fbezruchko/miro_production/README.md

# miro_production
All you need to make your own MIRO

In 3D print parts folders:
STL - STL files of part as-is.
STLwSUPPORTS - STL with modeled easy-detachable supports for FDM 3D printer with 0,2 mm layer hight.
