fbezruchko/miro_production/MIRO PARTS LIST & MANUFACTURING (RU).pdf

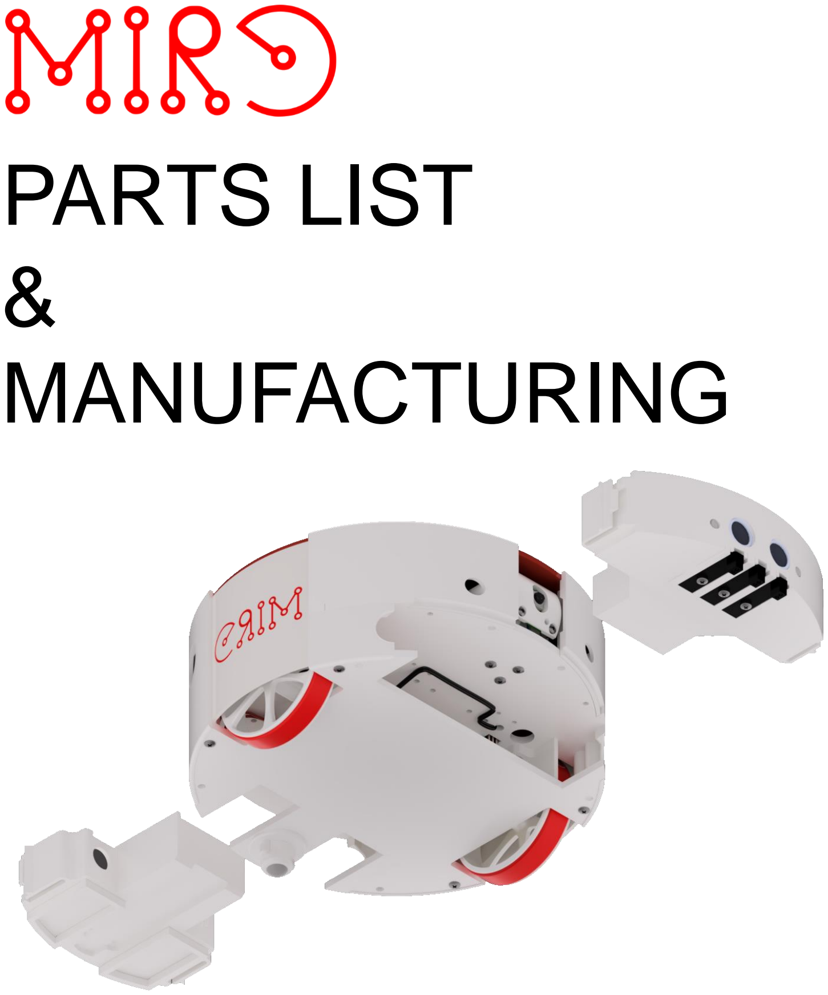
[picture p1: page 1]

# PARTS LIST

&

# MANUFACTURING

# PARTS LIST & MANUFACTURING

### 1. ПРОИЗВОДСТВО ИЗДЕЛИЙ МЕТОДОМ 3D FDM ПЕЧАТИ

№ | НАИМЕНОВАНИЕ | КОЛ-ВО | КОММЕНТАРИЙ
1 | 3 rd wheel pad | 1
2 | Back bottom cap (left) | 1
3 | Back bottom cap (right) | 1
4 | Back top cap (left) | 1
5 | Back top cap (right) | 1
6 | Front bottom cap (left) | 1
7 | Front bottom cap (right) | 1
8 | Front top cap (left) | 1
9 | Front top cap (right) | 1
10 | Battery box | 1
11 | Cover clips | 2
12 | Camera holder | 1
13 | Servo holder | 1
14 | Odometry wheel | 2
15 | Motor holder (left) | 1
16 | Motor holder (right) | 1
17 | Wheel | 2
18 | Back module (Default) | 1
19 | Handle | 1
20 | Front module SENS1 housing | 1 | SENS1
ИЗОБРАЖЕНИЕ | ОПИСАНИЕ

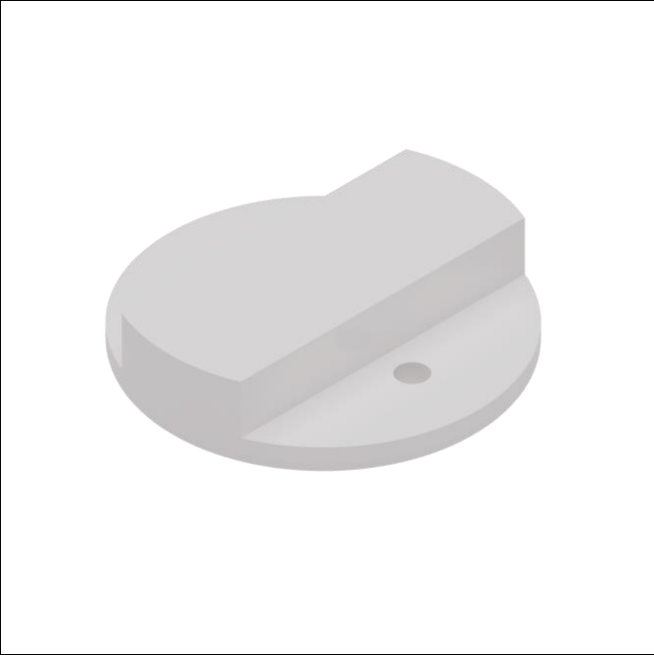
[picture p2: figure]

| 3 rd wheel pad Пластик: белый PLA или PETG Заполнение: 15% Поддержки: необязательны Периметров: 3 Критический угол без поддержки: 45О Высота слоя: 0,2мм Ширина линии слоя: 0,4мм Диаметр сопла: 0,4мм

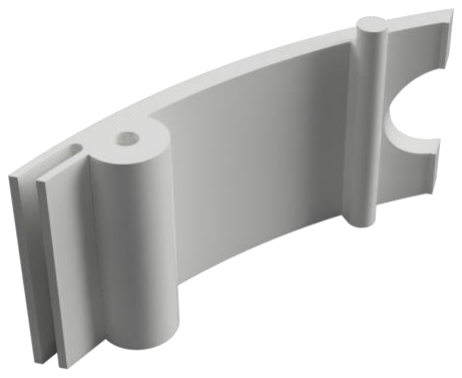
[picture p3: figure]

Back bottom cap (left) Пластик: белый PLA или PETG Заполнение: 15% Поддержки: не нужны Периметров: 4 Критический угол без поддержки: 45О Высота слоя: 0,2мм Ширина линии слоя: 0,4мм Диаметр сопла: 0,4мм

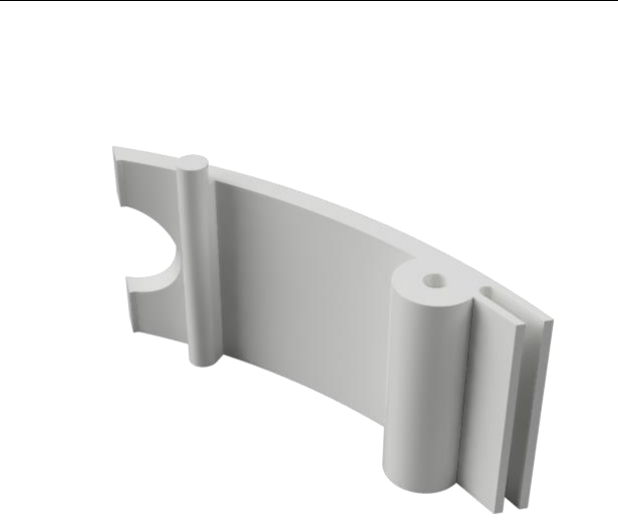
[picture p4: figure]

Back bottom cap (right) Пластик: белый PLA или PETG Заполнение: 15% Поддержки: не нужны Периметров: 4 Критический угол без поддержки: 45О Высота слоя: 0,2мм Ширина линии слоя: 0,4мм Диаметр сопла: 0,4мм

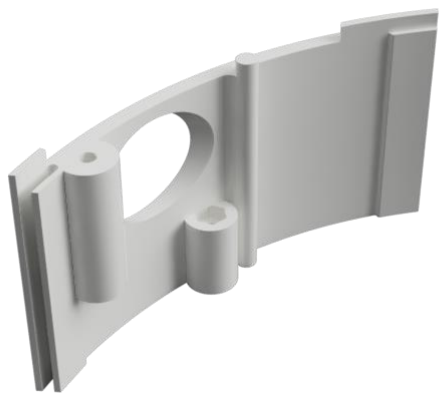
[picture p5: figure]

Back top cap (left)

Пластик: белый PLA или PETG Заполнение: 15%
Поддержки: необходимы
Периметров: 4
Максимальное кол-во слоев поддержки: 100 Критический угол без поддержки: 45О Высота слоя: 0,2мм
Ширина линии слоя: 0,4мм
Диаметр сопла: 0,4мм

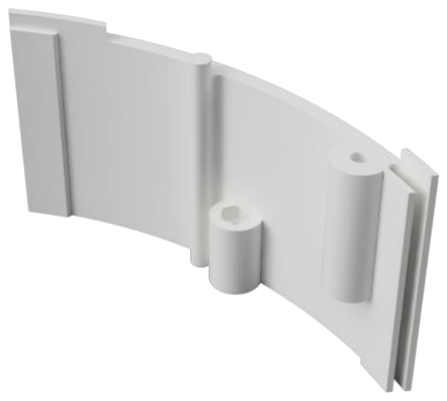
[picture p6: figure]

Back top cap (right)

Пластик: белый PLA или PETG Заполнение: 15%
Поддержки: необходимы
Периметров: 4
Максимальное кол-во слоев поддержки: 100 Критический угол без поддержки: 45О Высота слоя: 0,2мм
Ширина линии слоя: 0,4мм
Диаметр сопла: 0,4мм

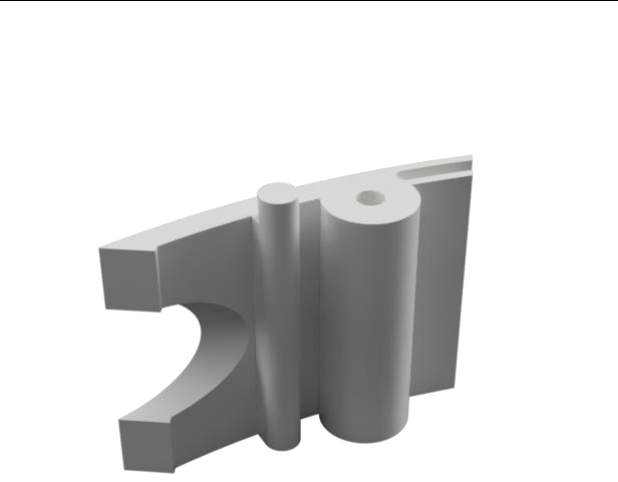
[picture p7: figure]

Front bottom cap (left)
Front bottom cap (right)

Пластик: белый PLA или PETG Заполнение: 15%
Поддержки: не нужны
Периметров: 4
Критический угол без поддержки: 45О Высота слоя: 0,2мм
Ширина линии слоя: 0,4мм
Диаметр сопла: 0,4мм
Детали симметричны

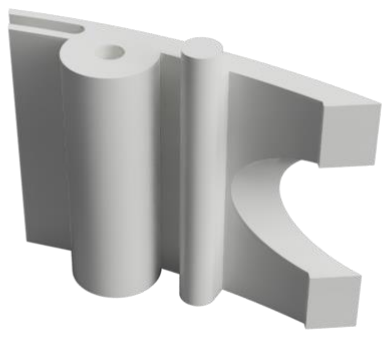
[picture p8: figure]

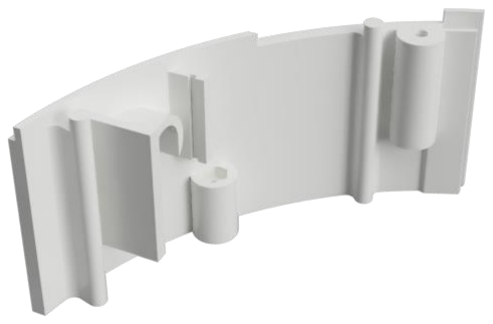
[picture p9: figure]

Front top cap (left)
Front top cap (right)

Пластик: белый PLA или PETG Заполнение: 15%
Поддержки: необходимы
Периметров: 4
Критический угол без поддержки: 45О Высота слоя: 0,2мм
Ширина линии слоя: 0,4мм
Диаметр сопла: 0,4мм
Детали симметричны

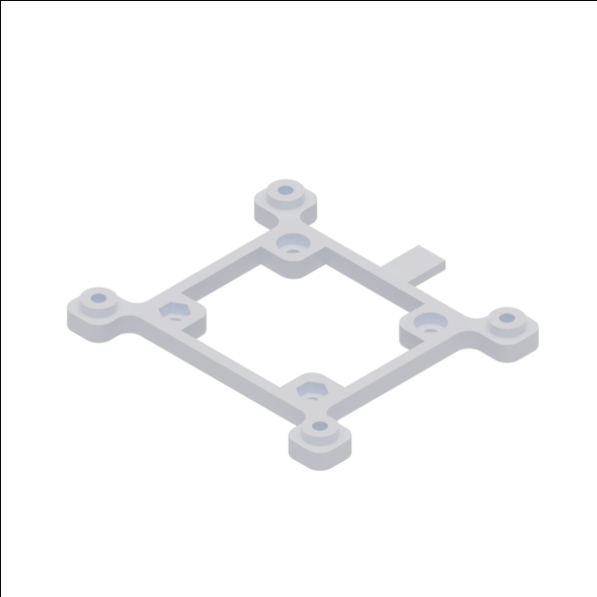
[picture p10: figure]

Raspberry Pi pad

Пластик: белый PLA или PETG Заполнение: 15%
Поддержки: не нужны
Периметров: 3
Слоев с полным заполнением (сверху): 3 Слоев с полным заполнением (снизу): 3 Максимальное кол-во слоев поддержки: 7 Критический угол без поддержки: 45О Высота слоя: 0,2мм
Ширина линии слоя: 0,4мм
Диаметр сопла: 0,4мм

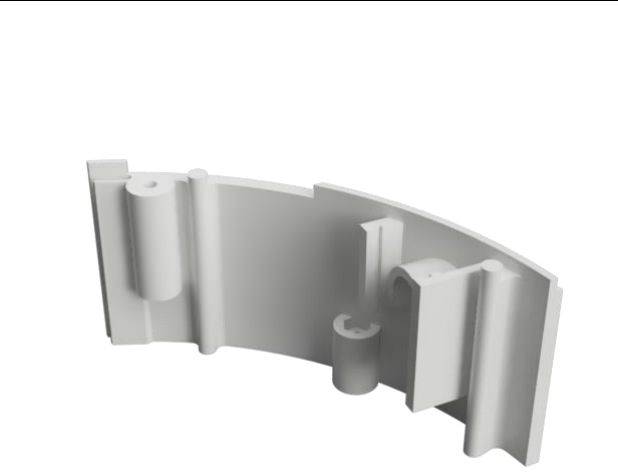
[picture p11: figure]

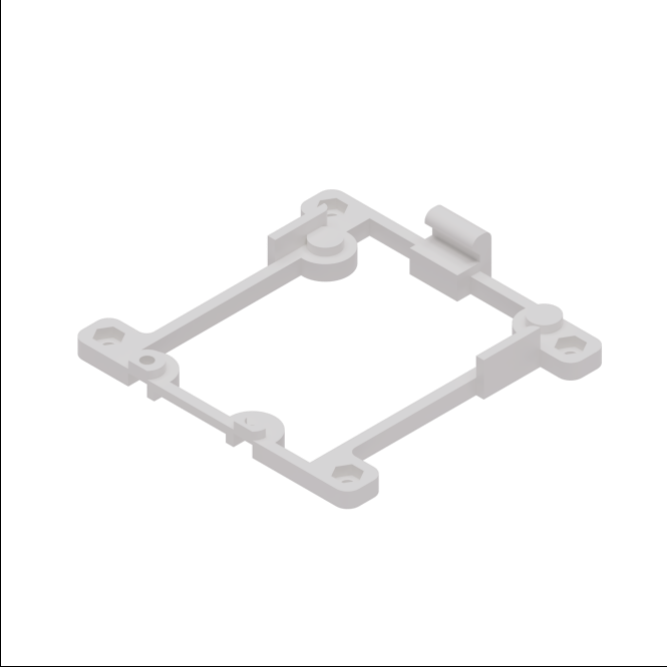
[picture p12: figure]

Arduino pad Пластик: белый PLA или PETG Заполнение: 15% Поддержки: не нужны Периметров: 3 Критический угол без поддержки: 45О Высота слоя: 0,2мм Ширина линии слоя: 0,4мм Диаметр сопла: 0,4мм

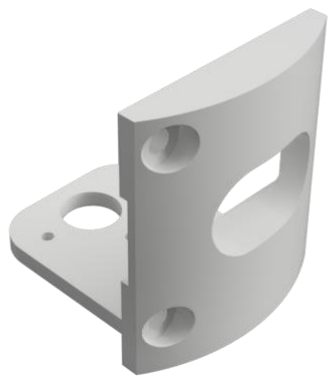
[picture p13: figure]

Camera holder Пластик: белый PLA или PETG Заполнение: 15% Поддержки: необязательны Периметров: 3 Критический угол без поддержки: 45О Высота слоя: 0,2мм Ширина линии слоя: 0,4мм Диаметр сопла: 0,4мм

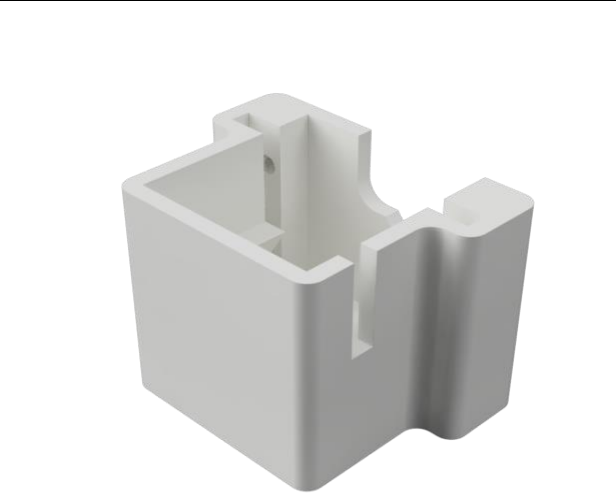
[picture p14: figure]

Servo holder

Пластик: белый PLA или PETG Заполнение: 15%
Поддержки: не нужны
Периметров: 3
Критический угол без поддержки: 45О Высота слоя: 0,2мм
Ширина линии слоя: 0,4мм
Диаметр сопла: 0,4мм

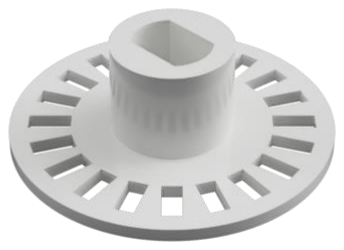
[picture p15: figure]

Odometry wheel

Пластик: белый PLA или PETG Заполнение: 15%
Поддержки: не нужны
Периметров: 3
Критический угол без поддержки: 45О Высота слоя: 0,2мм
Ширина линии слоя: 0,4мм
Диаметр сопла: 0,4мм

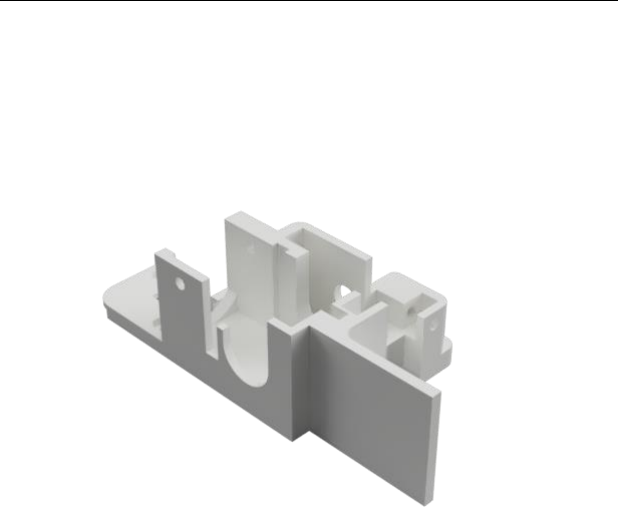
[picture p16: figure]

Motor holder (left)
Motor holder (right)

Пластик: белый PLA или PETG Заполнение: 15%
Поддержки: не нужны
Периметров: 4
Критический угол без поддержки: 45О Максимальное кол-во слоев поддержки: 30 Высота слоя: 0,2мм
Ширина линии слоя: 0,4мм
Диаметр сопла: 0,4мм
Детали симметричны

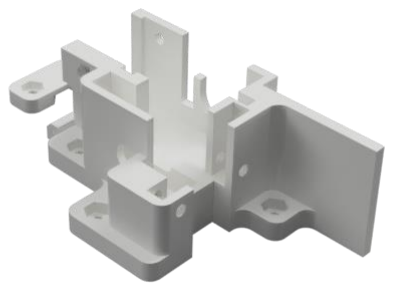
[picture p17: figure]

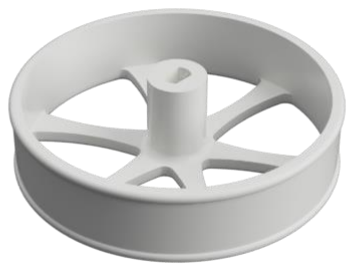
[picture p18: figure]

Wheel Пластик: белый PLA или PETG Заполнение: 15% Поддержки: не нужны Периметров: 3 Критический угол без поддержки: 45О Высота слоя: 0,2мм Ширина линии слоя: 0,4мм Диаметр сопла: 0,4мм

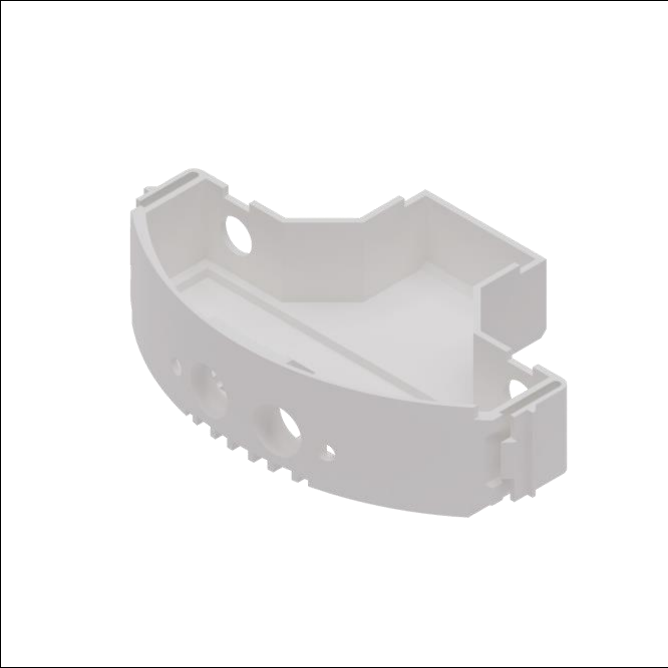
[picture p19: figure]

Front module (Default) Пластик: белый PLA или PETG Заполнение: 15% Поддержки: необходимы Периметров: 4 Максимальное кол-во слоев поддержки: 30 Поддержки на пролетах: Да Критический угол без поддержки: 45О Высота слоя: 0,2мм Ширина линии слоя: 0,4мм Диаметр сопла: 0,4мм

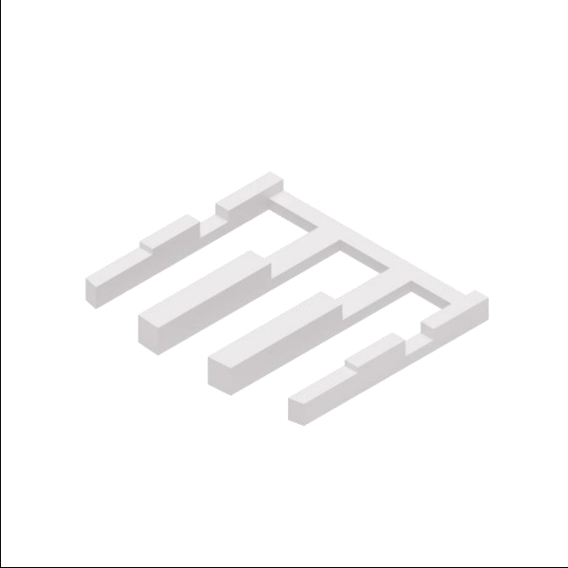
[picture p20: figure]

Front module follower Пластик: белый PLA или PETG Заполнение: 15% Поддержки: не нужны Периметров: 3 Критический угол без поддержки: 45О Высота слоя: 0,2мм Ширина линии слоя: 0,4мм Диаметр сопла: 0,4мм

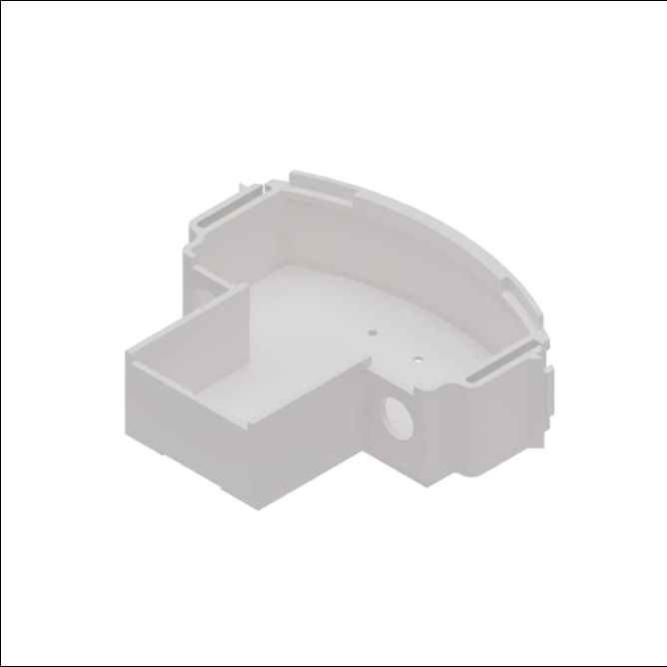
[picture p21: figure]

Back module (Default) Пластик: белый PLA или PETG Заполнение: 15% Поддержки: необязательны Периметров: 4 Максимальное кол-во слоев поддержки: 30 Поддержки на пролетах: Да Критический угол без поддержки: 45О Высота слоя: 0,2мм Ширина линии слоя: 0,4мм Диаметр сопла: 0,4мм

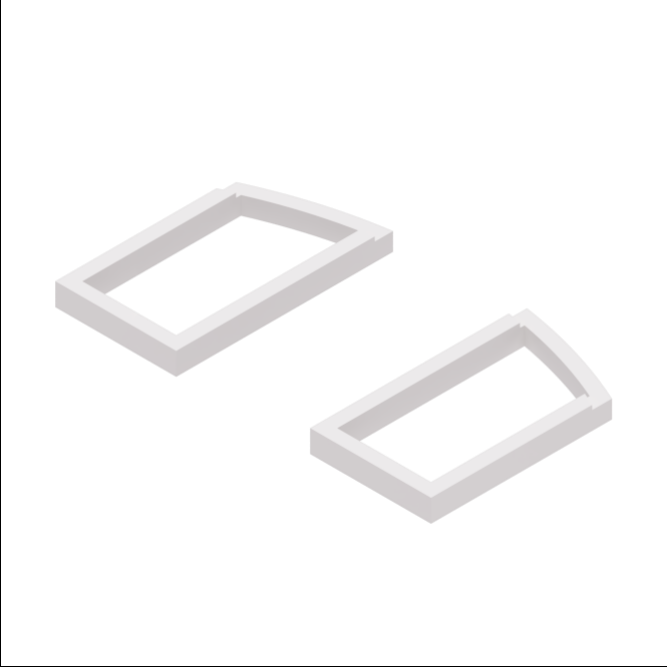
[picture p22: figure]

Back module follower Пластик: белый PLA или PETG Заполнение: 15% Поддержки: не нужны Периметров: 3 Критический угол без поддержки: 45О Высота слоя: 0,2мм Ширина линии слоя: 0,4мм Диаметр сопла: 0,4мм

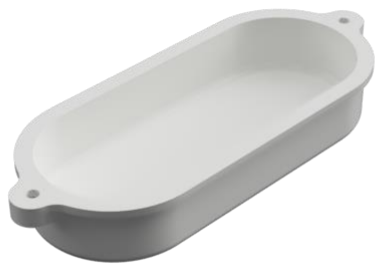
[picture p23: figure]

Handle Пластик: белый PLA или PETG Заполнение: 15% Поддержки: необходимы Периметров: 3 Критический угол без поддержки: 45О Высота слоя: 0,2мм Ширина линии слоя: 0,4мм Диаметр сопла: 0,4мм

### 1.1 ПРОИЗВОДСТВО ИЗДЕЛИЙ МЕТОДОМ 3D FDM ПЕЧАТИ (ПЕРЕДНИЙ

МОДУЛЬ SENS1)

ИЗОБРАЖЕНИЕ | ПОЯСНЕНИЕ

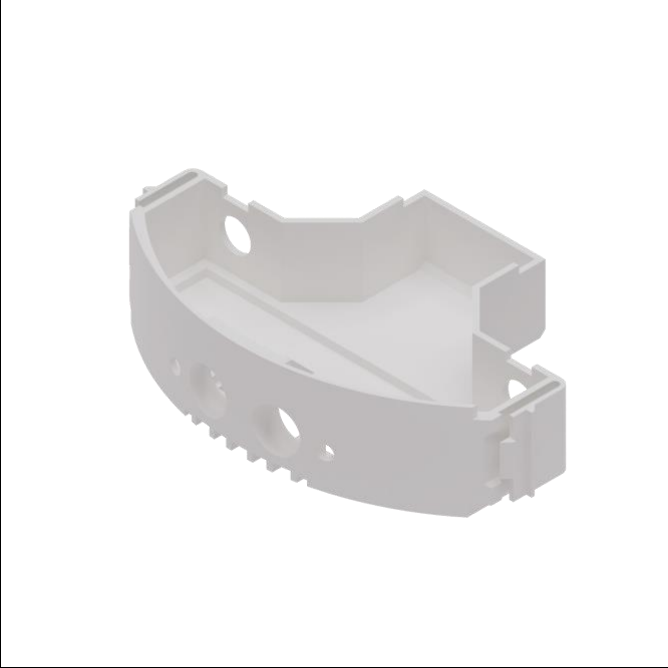
[picture p24: figure]

| Front module SENS1 housing Пластик: белый PLA или PETG Заполнение: 15% Поддержки: необходимы Периметров: 4 Максимальное кол-во слоев поддержки: 30 Поддержки на пролетах: Да Критический угол без поддержки: 45О Высота слоя: 0,2мм Ширина линии слоя: 0,4мм Диаметр сопла: 0,4мм

### 2. ПРОИЗВОДСТВО ИЗДЕЛИЙ ИЗ ЛИСТОВЫХ МАТЕРИАЛОВ МЕТОДАМИ

ЛАЗЕРНОЙ РЕЗКИ ИЛИ ФЕЗЕРОВКОЙ

№ | НАИМЕНОВАНИЕ | КОЛ-ВО | КОММЕНТАРИЙ
1 | Bottom plate | 1
2 | Base plate | 1
3 | Top plate | 1
4 | Battery cover | 1
5 | PVC cap template back | 1
6 | PVC cap template left_right | 2
ИЗОБРАЖЕНИЕ | ОПИСАНИЕ

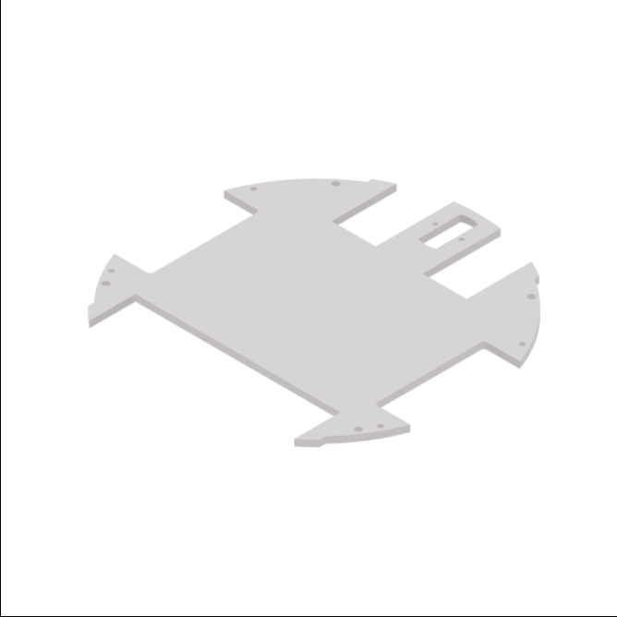
[picture p25: figure]

| Bottom plate Материал: акрил/фанера 4мм. Исходный формат: *.step, *.dxf

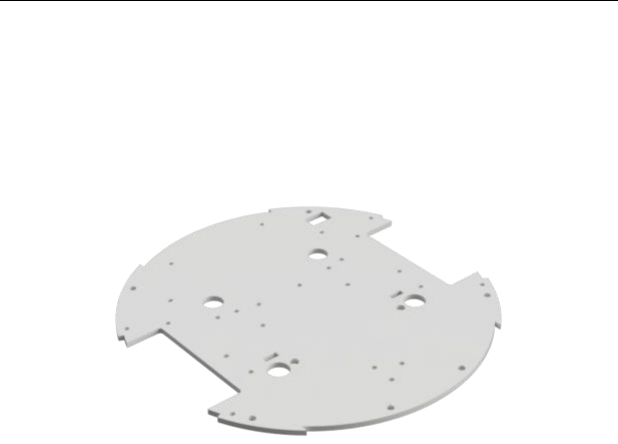
[picture p26: figure]

Base plate

Материал: фанера 4мм
Исходный формат: *.step, *.dxf

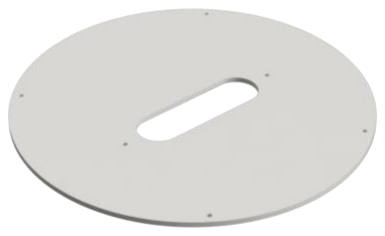
[picture p27: figure]

Top plate Материал: акрил/фанера 4мм Исходный формат: *.step, *.dxf

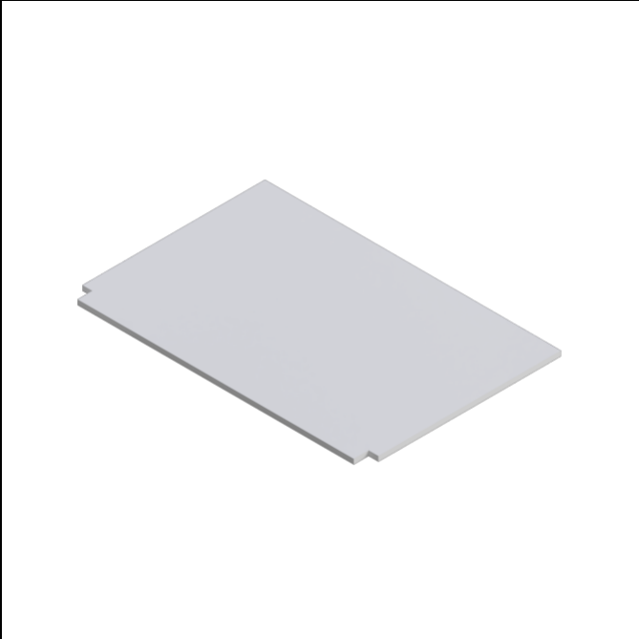
[picture p28: figure]

PVC cap template back Материал: ПВХ 1-2мм или картон Исходный формат: *.step, *.dxf Шаблон подготовлен с учетом радиального искривления при монтаже в сборке.

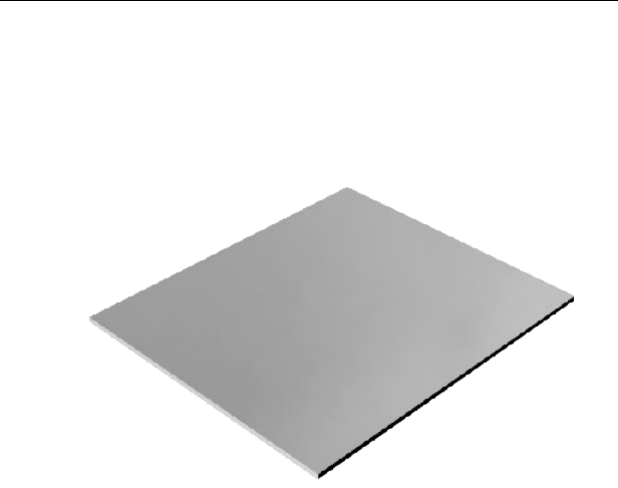
[picture p29: figure]

PVC cap template left_right

Материал: ПВХ 1-2мм или картон Исходный формат: *.step, *.dxf
Шаблон подготовлен с учетом радиального искривления при монтаже в сборке.

Возможно размещение логотипа «MIRO» или иного в виде наклейки 85х73мм с полями 8мм слева и справа по большей стороне (видимая часть: 69х73мм).

### 3. ДЕТАЛИ (ИЗДЕЛИЯ) ВЫПУСКАЕМЫЕ СЕРИЙНО СТОРОННИМИ

ПРОИЗВОДИТЕЛЯМИ

№ | НАИМЕНОВАНИЕ | КОЛ-ВО | КОММЕНТАРИЙ
1 | Silicone bracelet | 2
2 | rd wheel 3 | 1
3 | DC Geared Motor | 2
4 | Servo SG-90 | 1
5 | Odometry sensor | 2
6 | Motor driver (L9110S) | 1
7 | LM2596 DC-DC | 1
8 | RobotDyn Mod-buzzer | 1
9 | RobotDyn Mod-LED-Piranha | 2
10 | ARDUINO Sensor Board | 1
11 | RobotDyn UNO+WiFi Board | 1
12 | Raspberry Pi Cam | 1
13 | Raspberry Pi Zero W | 1
14 | Switch KCD1-11 | 1
15 | Battery | 1
16 | Raspberry Pi Cam Zero Wire | 1
17 | Wire BLS-3 | 9
18 | RobotDyn Sens-LineTrack | 3 | SENS1
19 | RobotDyn Sens-LightADout | 2 | SENS1
20 | HC-SR04 | 1 | SENS1
21 | Wire Servo | 6 | SENS1
22 | Wire BLS-4 | 1 | SENS1
23 | Connector BLS-2 | 2 | SENS1
ИЗОБРАЖЕНИЕ | ОПИСАНИЕ

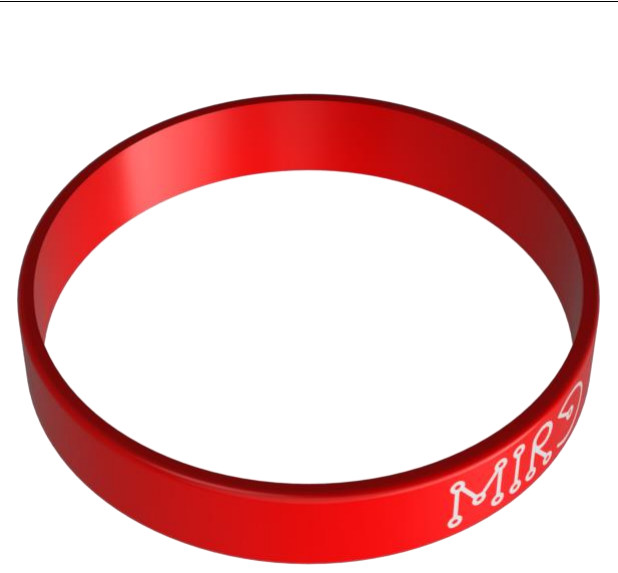
[picture p30: figure]

| Silicone bracelet Силиконовый браслет D=65мм, H=12мм. Возможно нанесение логотипа «MIRO» или любого другого.

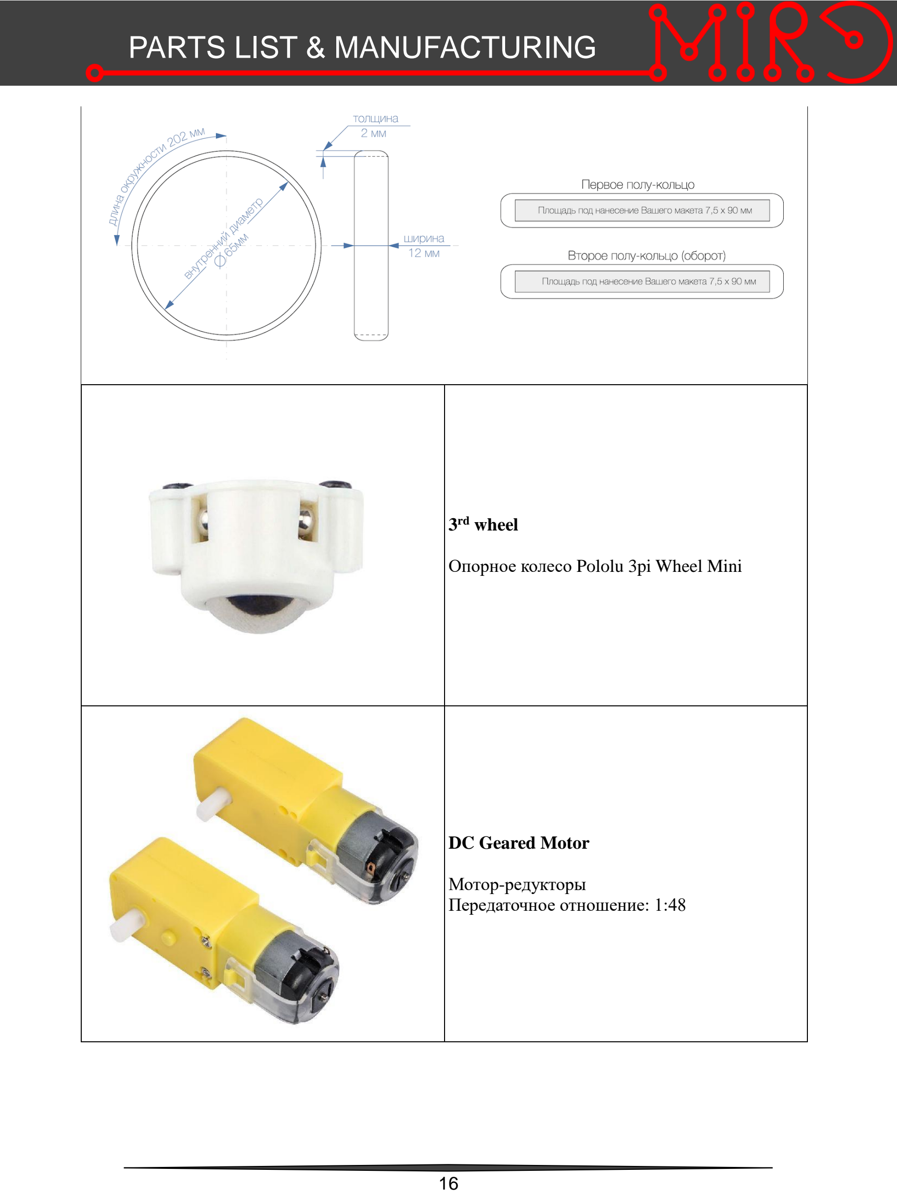
[picture p31: page 16]

rd wheel 3 Опорное колесо Pololu 3pi Wheel Mini

DC Geared Motor Мотор-редукторы Передаточное отношение: 1:48

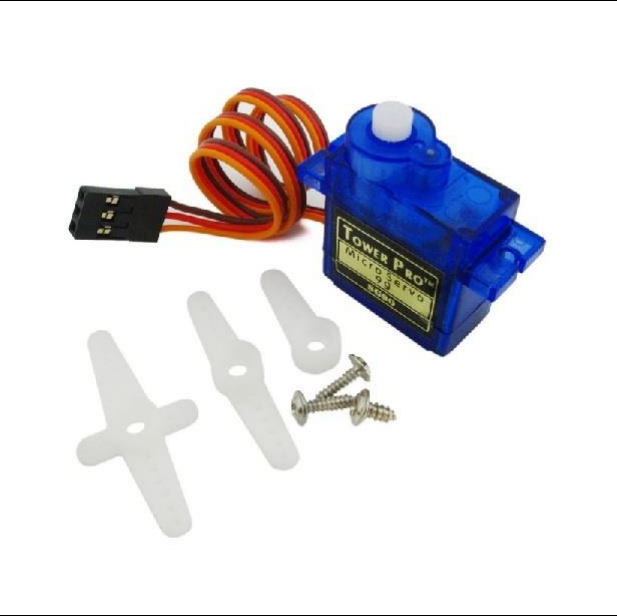
[picture p32: figure]

Servo SG-90 Сервопривод TowerPro SG-90 (с комплектом крепежа и качельками) Напряжение питания: 4.8 – 6.0 В Крутящий момент: 2,5 кг/см Масса: 14,7г

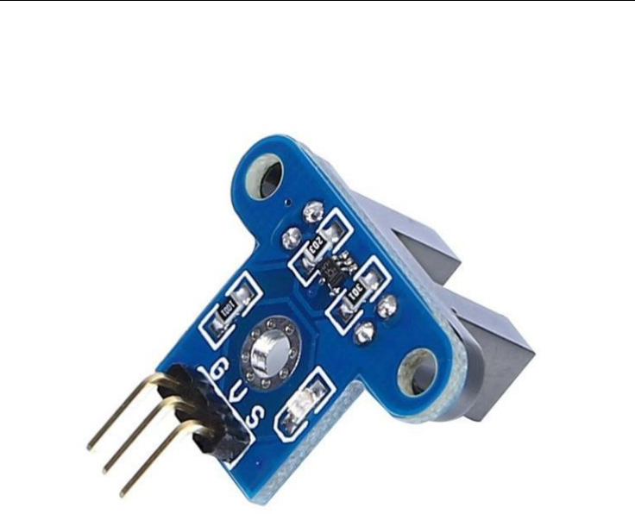
[picture p33: figure]

Odometry sensor Оптический щелевой прерыватель (датчик энкодер)

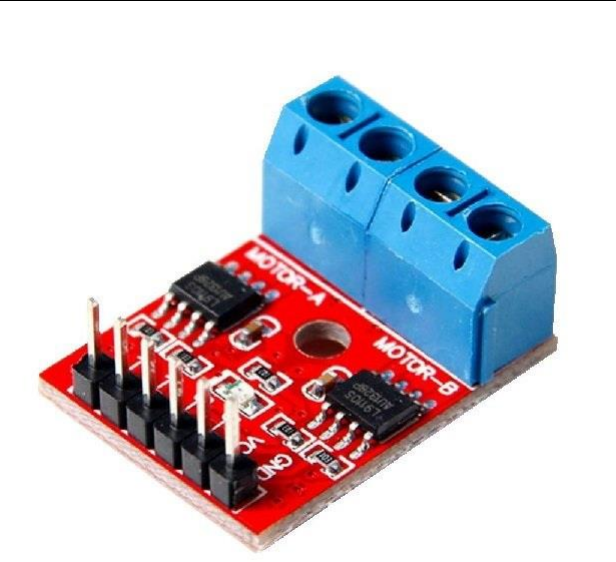
[picture p34: figure]

Motor driver (L9110S)

Драйвер коллекторных двигателей на микросхемах L9110S (всего 2 канала). Максимальный ток на канал: 0.8А (1.2А краткосрочная пиковая нагрузка). Напряжение питания: 2.5 – 12В.

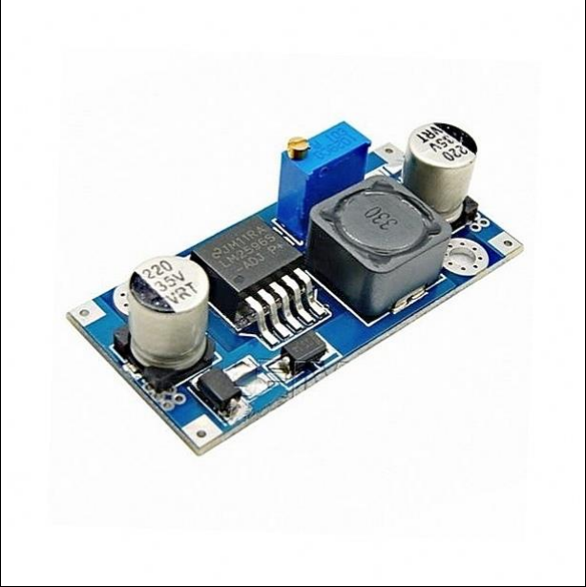
[picture p35: figure]

LM2596 DC-DC Понижающий DC-DC преобразователь на микросхеме LM2596. Максимальный выходной ток: 2А Входное напряжение: 4.0 - 40В Выходное напряжение: 1.5 – 35В

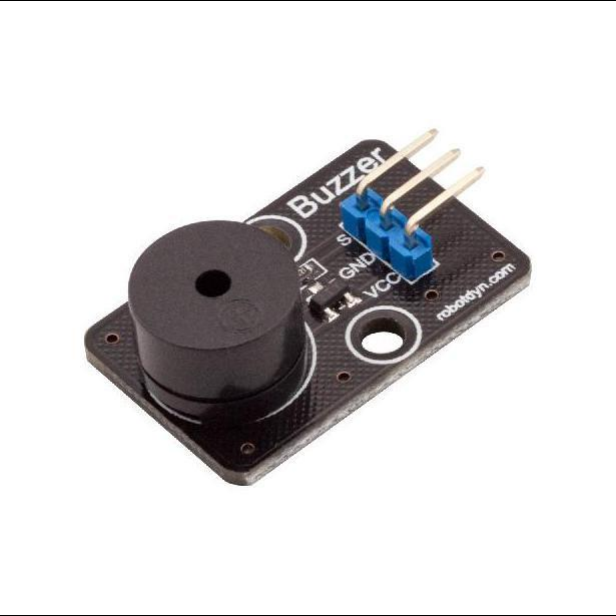
[picture p36: figure]

RobotDyn Mod-buzzer Модель с пьезоизлучателем RobotDyn Mod-buzzer

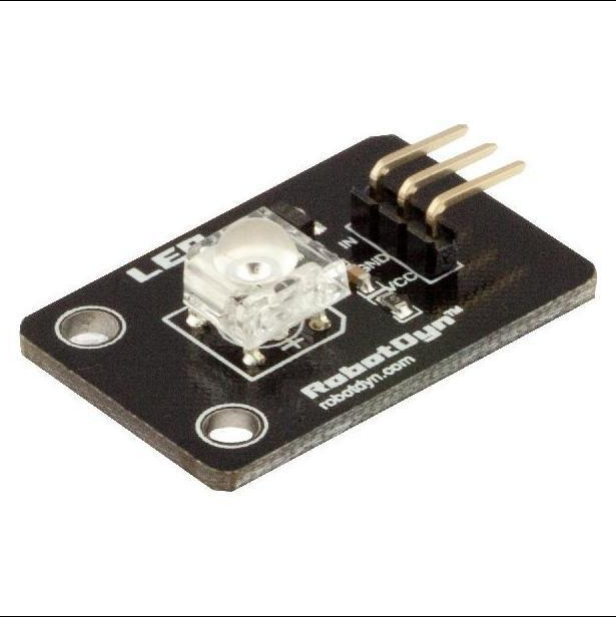
[picture p37: figure]

RobotDyn Mod-LED-Piranha Модуль с сверхярким светодиодом RobotDyn Mod-LED-Piranha (белый)

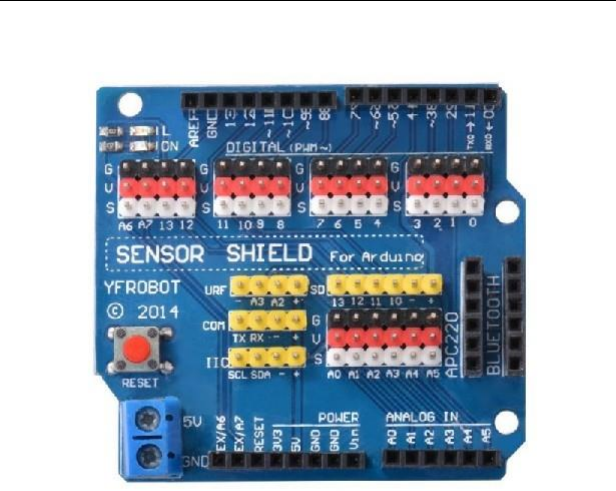
[picture p38: figure]

ARDUINO Sensor Board Плата расширения ARDUINO Sensor Shield 5.0

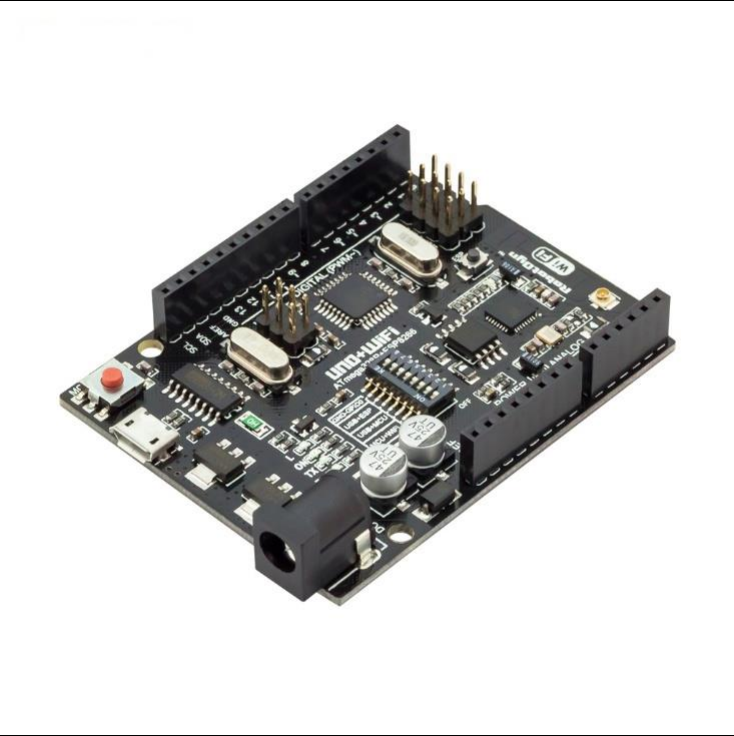
[picture p39: figure]

RobotDyn UNO+WiFi Board Микроконтроллерная плата RobotDyn UNO+WiFi R3 ATmega328P+ESP8266, 8Mbit flash, USB-TTL CH340G, Micro-USB

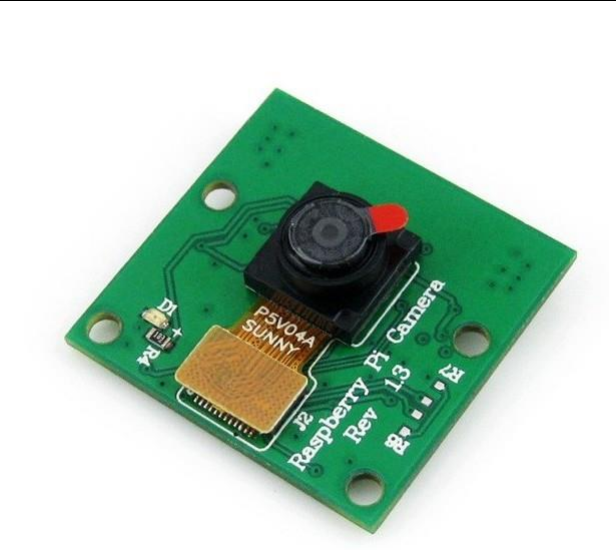
[picture p40: figure]

Raspberry Pi Cam Модуль Raspberry Pi Camera v1.3 с камерой Модуль: Omnivision 5647 Разрешение: 5 Мп Максимальное разрешение фото: 2592 х 1944 Разрешение видео: 1080p@30fps, 720p@60fps, 480p@90fps Интерфейс: 15-pin MIPI Camera Serial Interface Размеры: 20 x 25 x 9 мм Масса: 3г

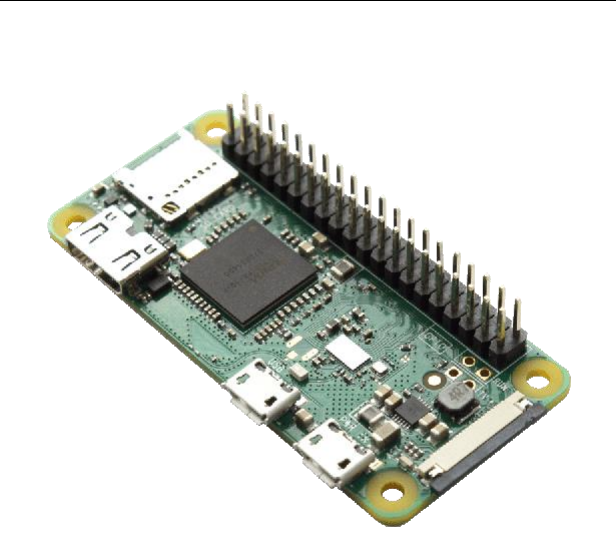
[picture p41: figure]

Raspberry Pi (Zero W, 1, 2, 3, 4) Микрокомпьютер Raspberry Pi

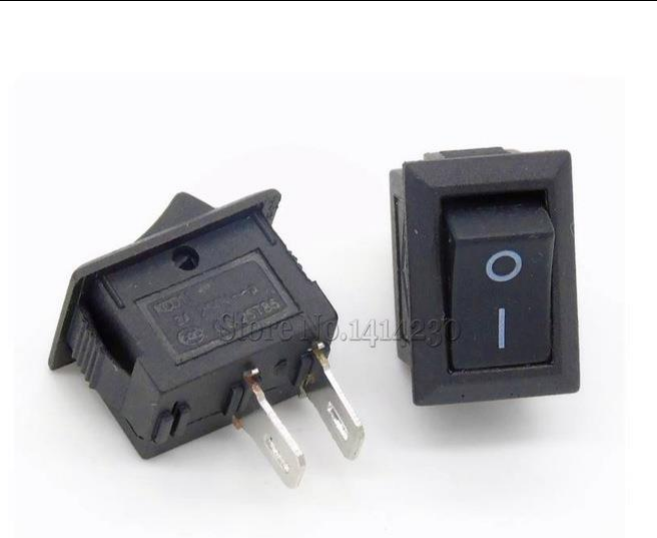
[picture p42: figure]

Switch KCD1-11 Тумблер KCD1-11

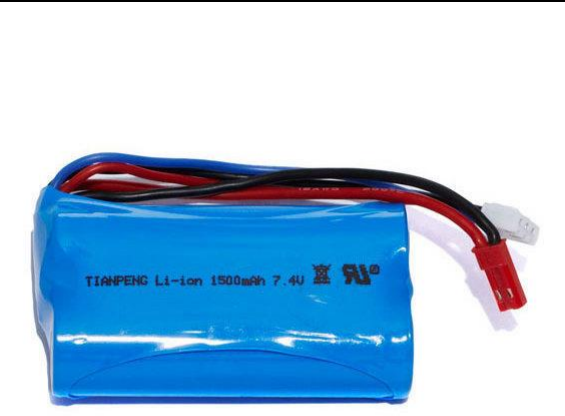
[picture p43: figure]

Battery Аккумулятор Li-Ion 7.4В 1500мАч Коннектор рабочий: JST RCY Female Коннектор балансировочный: JST XH 3pin Female

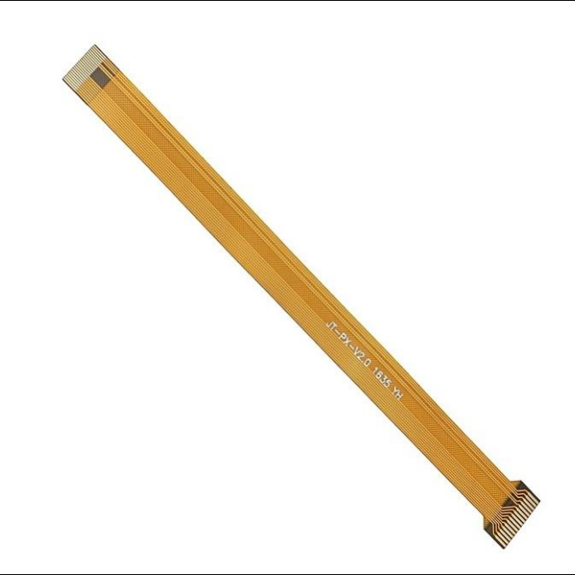
[picture p44: figure]

Raspberry Pi Cam Zero Wire Интерфейсный шлейф для подключения модуля камеры Raspberry Pi Camera v1.3 к Raspberry Pi Zero W.

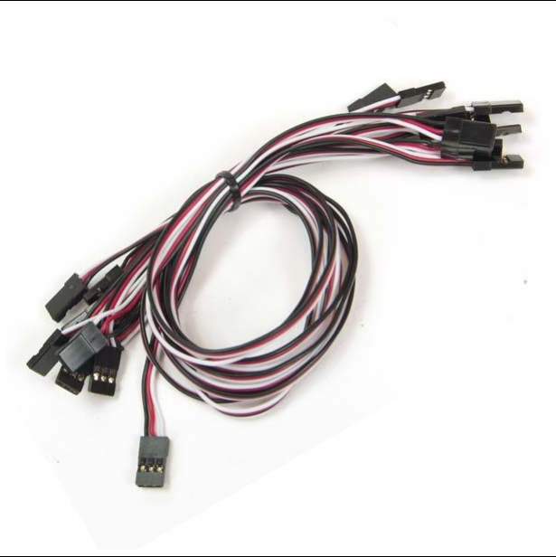
[picture p45: figure]

Wire BLS-3 Провод коммутационный 3 pin, 16см. Коннекторы (с обоих концов): BLS-3

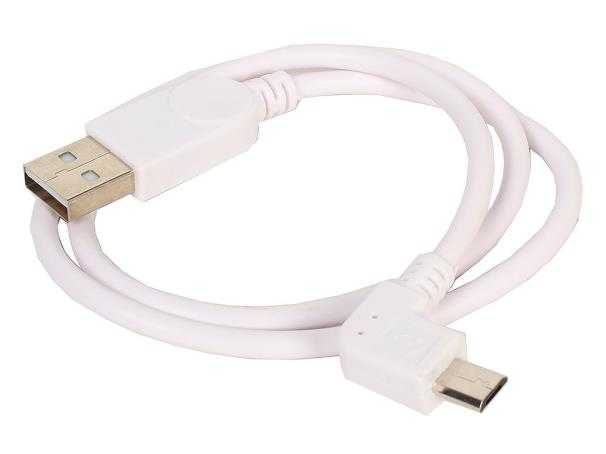
[picture p46: figure]

Кабель Micro USB

### 3.1 ДЕТАЛИ (ИЗДЕЛИЯ) ВЫПУСКАЕМЫЕ СЕРИЙНО СТОРОННИМИ

ПРОИЗВОДИТЕЛЯМИ (ПЕРЕДНИЙ МОДУЛЬ SENS1)

ИЗОБРАЖЕНИЕ | ПОЯСНЕНИЕ

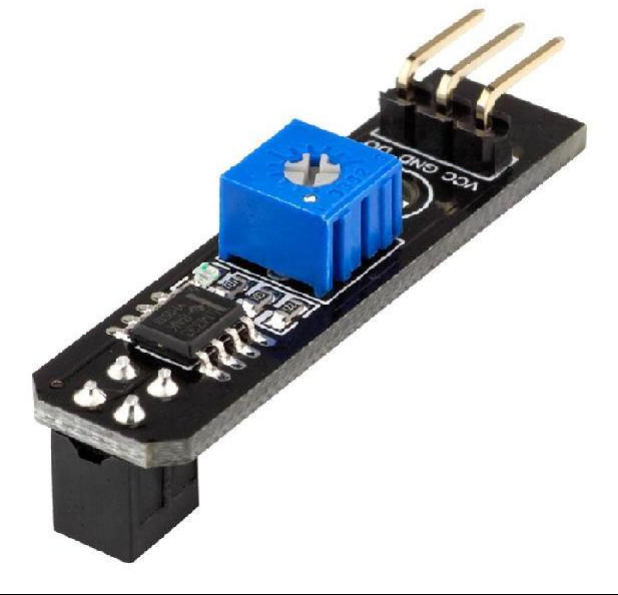
[picture p47: figure]

| RobotDyn Sens-LineTrack Инфракрасный датчик линии RobotDyn Sens-LineTrack.

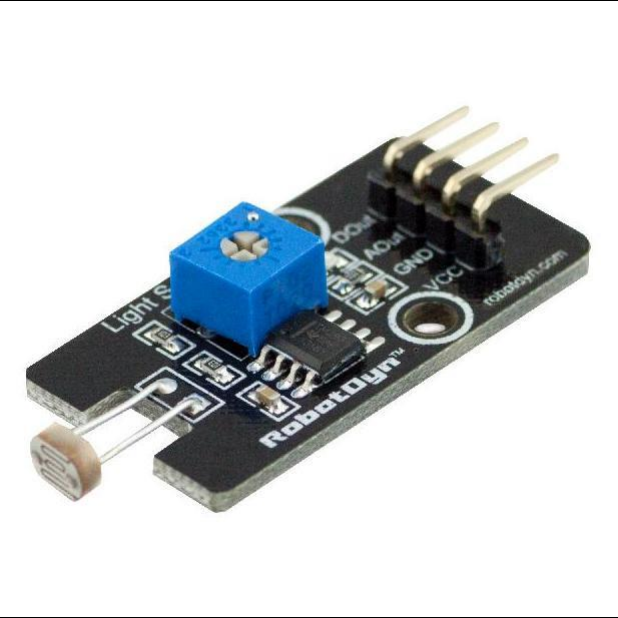
[picture p48: figure]

| RobotDyn Sens-LightADout Фоторезистивный датчик освещенности RobotDyn Sens-LightADout

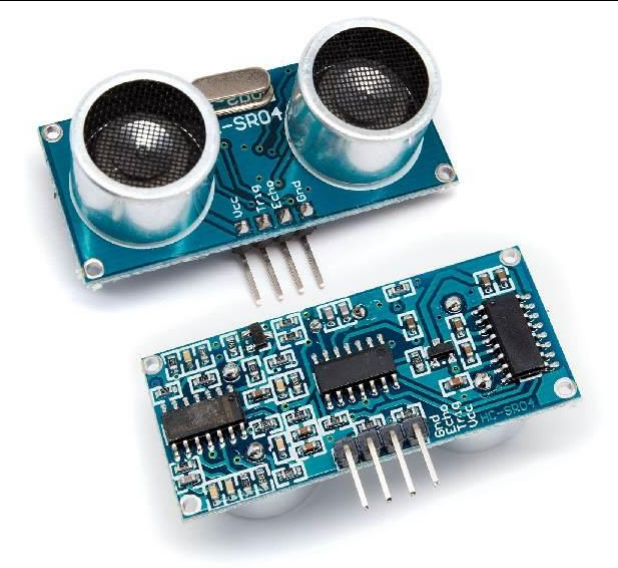
[picture p49: figure]

HC-SR04

Ультразвуковой дальномер HC-SR04

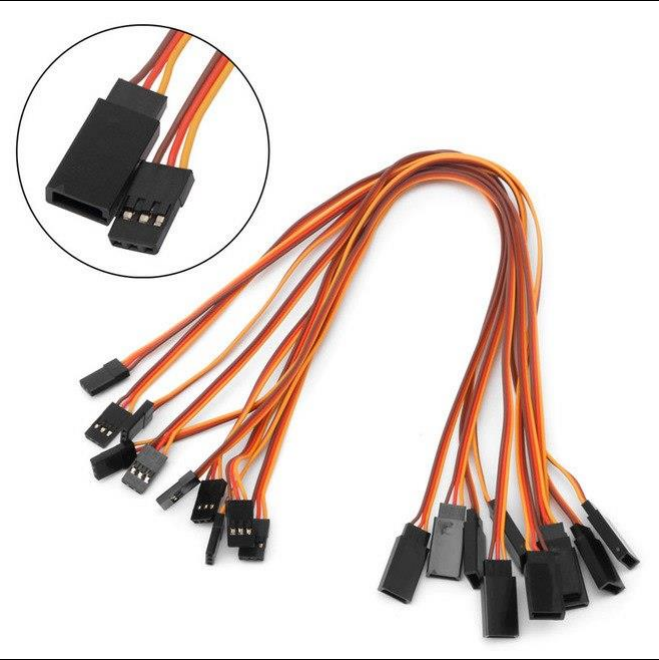
[picture p50: figure]

Wire Servo Провод коммутационный 16см. Коннекторы: BLS-3 Female и Male.

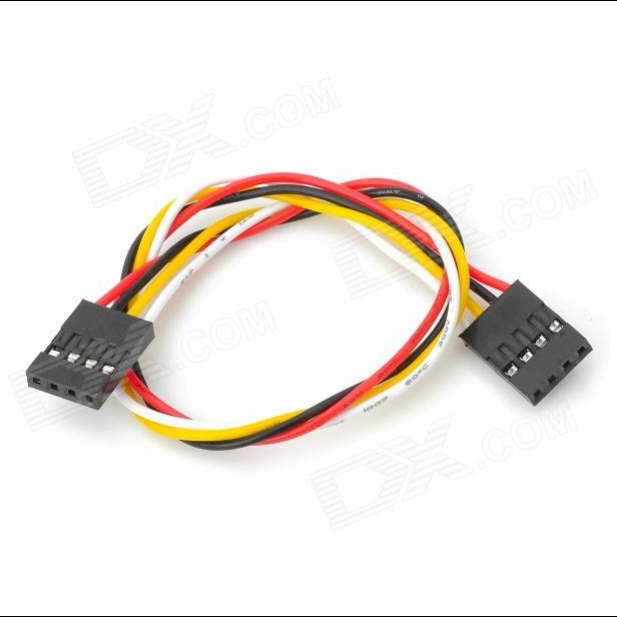
[picture p51: figure]

Wire BLS-4 Провод коммутационный 4 pin, 16см. Коннекторы (с обоих концов): BLS-4

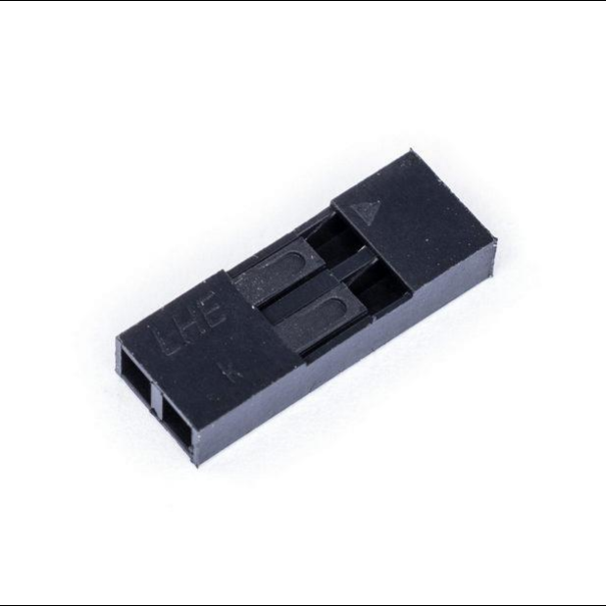
[picture p52: figure]

Connector BLS-2 Коннектор BLS-2

### 4. КРЕПЕЖНЫЕ ИЗДЕЛИЯ

НАИМЕНОВАНИЕ | КОЛ-ВО | ПОЯСНЕНИЕ
Винт М3х60 | 4 | DIN 7985, ГОСТ 17473, полукруглая головка крест, оцинкованный
Винт М3х25 | 2 | DIN 7985, ГОСТ 17473, полукруглая головка крест, оцинкованный
Винт М3х20 | 4 | DIN 7985, ГОСТ 17473, полукруглая головка крест, оцинкованный
Винт М3х16 | 2 | DIN 7985, ГОСТ 17473, полукруглая головка крест, оцинкованный
Винт М3х10 | 4 | DIN 7985, ГОСТ 17473, полукруглая головка крест, оцинкованный
Винт М3х8 | 19 | DIN 7985, ГОСТ 17473, полукруглая головка крест, оцинкованный
Винт М2.5х8 | 2 | DIN 7985, ГОСТ 17473, полукруглая головка крест, оцинкованный
Винт М2.5х6 | 2 | DIN 7985, ГОСТ 17473, полукруглая головка крест, оцинкованный
Гайка М3 | 35 | DIN 934, шестигранная оцинкованная
Гайка М2.5 | 2 | DIN 934, шестигранная оцинкованная

### 4.1 КРЕПЕЖНЫЕ ИЗДЕЛИЯ (ПЕРЕДНИЙ МОДУЛЬ SENS1)

НАИМЕНОВАНИЕ | КОЛ-ВО | ПОЯСНЕНИЕ
Винт М3х8 | 3 | DIN 7985, ГОСТ 17473, полукруглая головка крест, оцинкованный
Гайка М3 | 3 | DIN 934, шестигранная оцинкованная
