fbezruchko/miro_production/3D print parts/STL/3rdWheel/rotor.stl

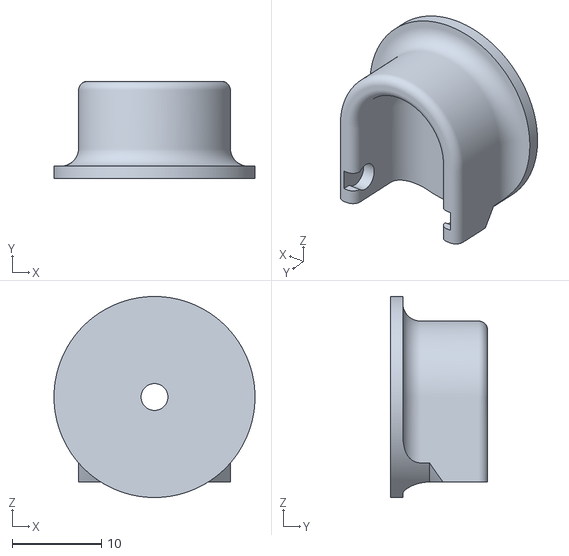
[picture p53: CAD file, 2019-07-06]
3D print parts/STL/3rdWheel/rotor.stl
22.5 x 10.9 x 22.5
