fbezruchko/miro_production/3D print parts/STL/Wires holder 1 unSupport.stl

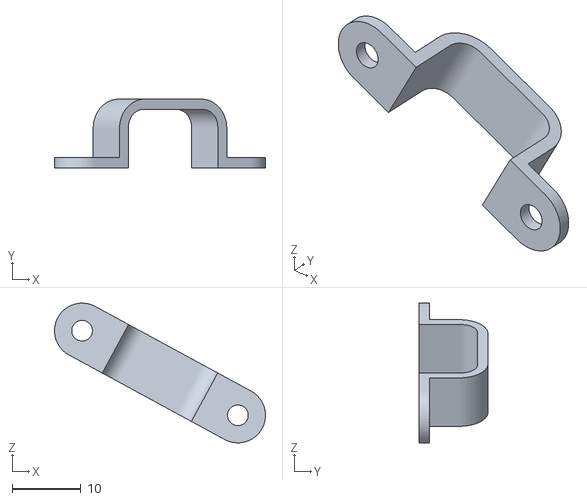
[picture p54: CAD file, 2019-10-15]
3D print parts/STL/Wires holder 1 unSupport.stl
30.6 x 10.0 x 20.3
