fbezruchko/miro_production/Lasercut parts/Bottom plate.dxf

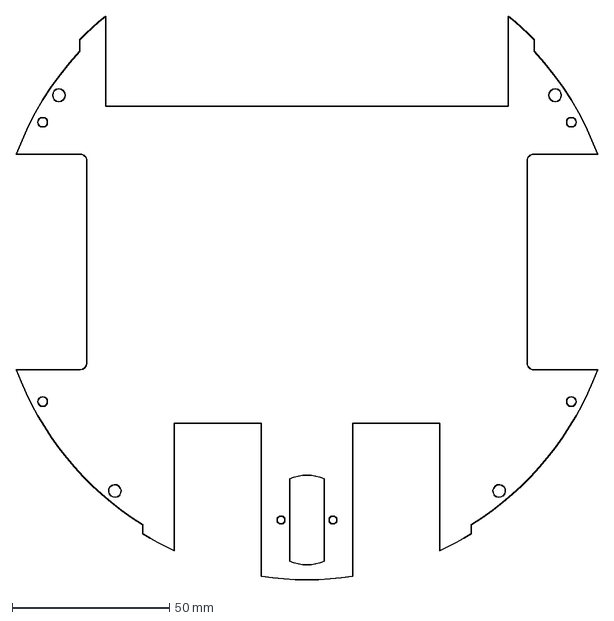
[picture p55: CAD file, 2019-10-15]
Lasercut parts/Bottom plate.dxf
184.7 x 179.5 mm
