fbezruchko/miro_production/PVC or cardboard/PVC cap (back).dxf

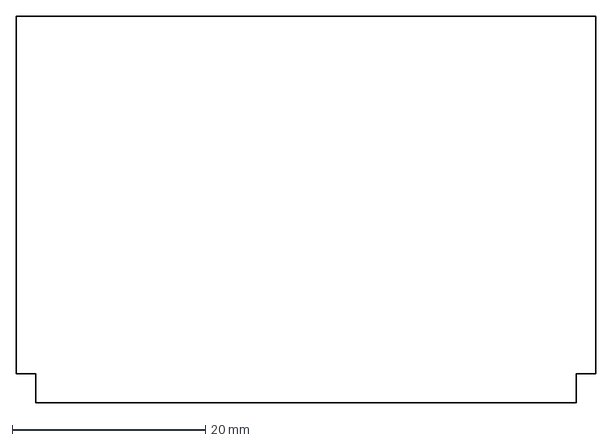
[picture p56: CAD file, 2019-10-15]
PVC or cardboard/PVC cap (back).dxf
60.0 x 40.0 mm
