fbezruchko/miro_production/3D print parts/STL/3rdWheel/wheel.stl

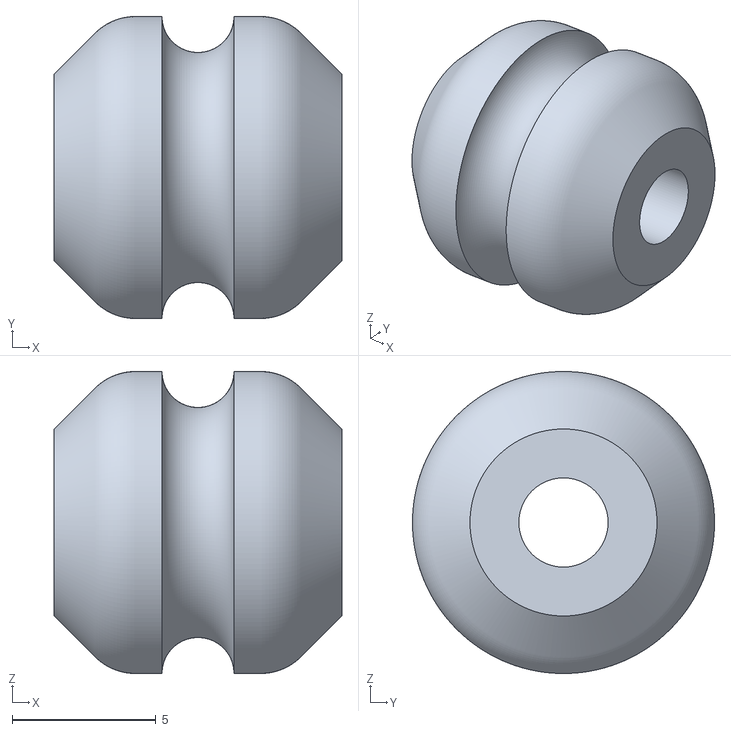
[picture p57: CAD file, 2019-07-06]
3D print parts/STL/3rdWheel/wheel.stl
10.0 x 10.5 x 10.5
