fbezruchko/miro_production/3D print parts/STL/Odometry wheel v2019 (x2) unSupport.stl

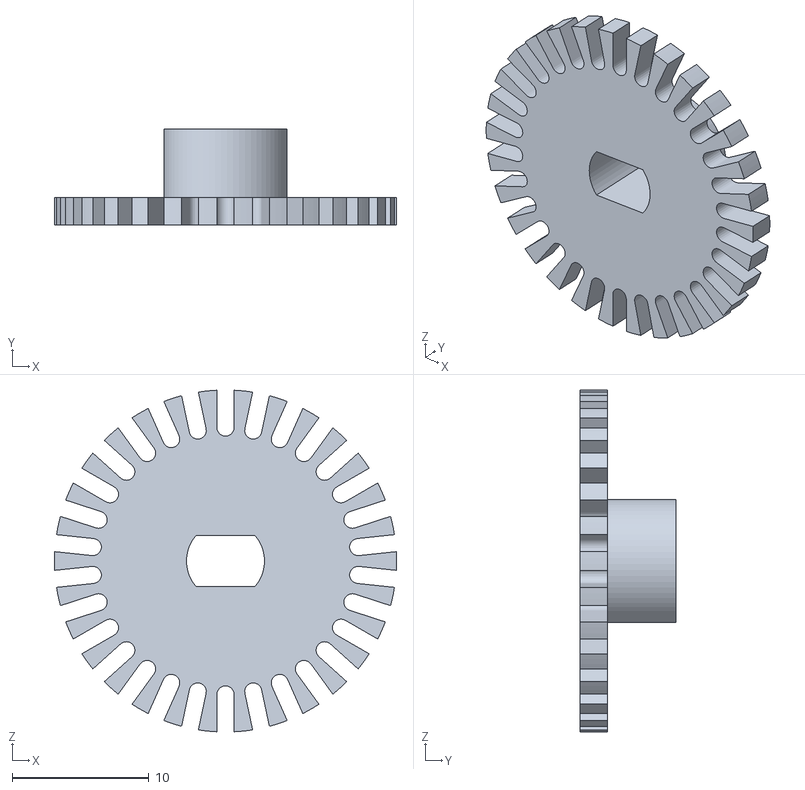
[picture p58: CAD file, 2019-10-15]
3D print parts/STL/Odometry wheel v2019 (x2) unSupport.stl
25.0 x 7.00 x 25.0
