fbezruchko/miro_production/Lasercut parts/Base plate.dxf

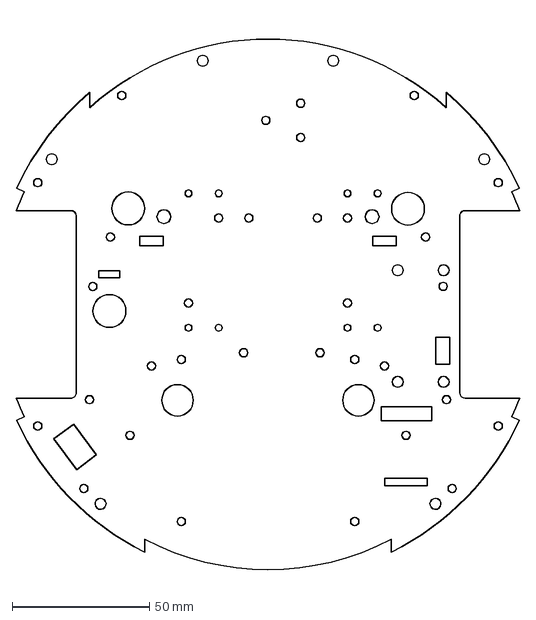
[picture p59: CAD file, 2019-10-15]
Lasercut parts/Base plate.dxf
183.6 x 205.7 mm
