fbezruchko/miro_production/PVC or cardboard/PVC cap.dxf

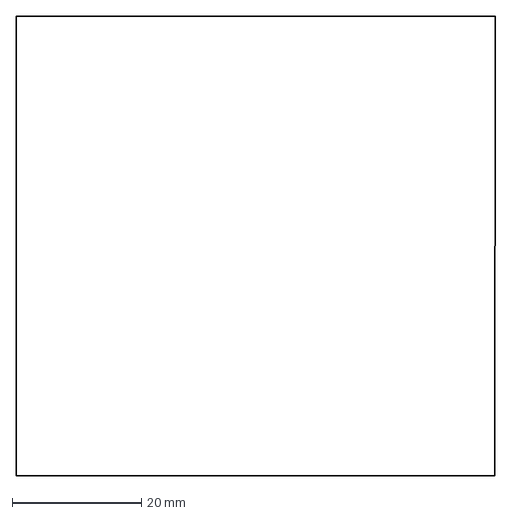
[picture p60: CAD file, 2019-10-15]
PVC or cardboard/PVC cap.dxf
74.0 x 71.0 mm
