fbezruchko/miro_production/3D print parts/STL/3rd wheel pad unSupport.stl

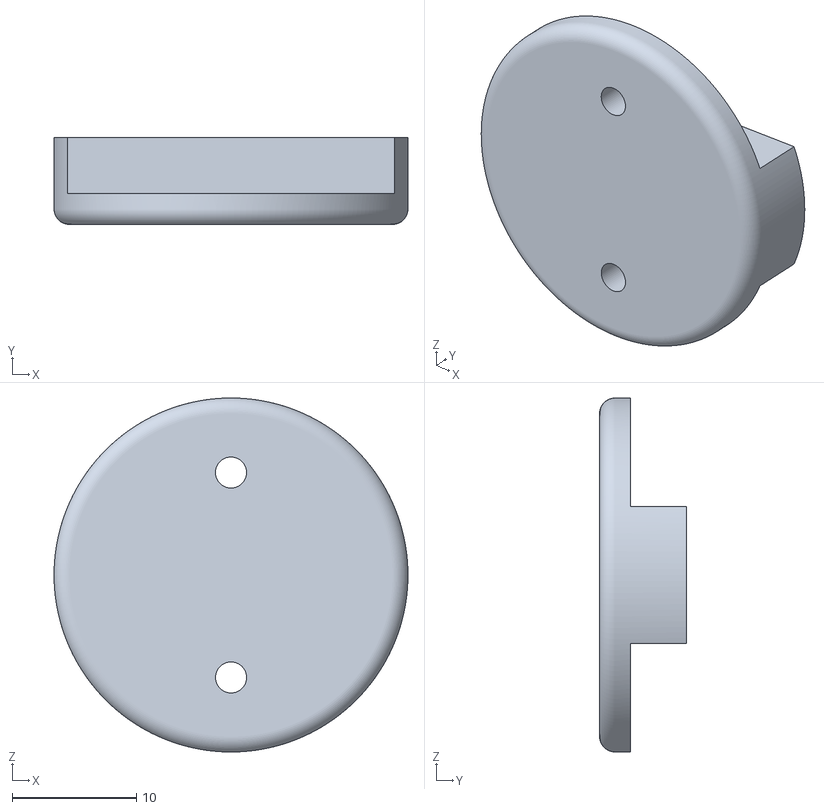
[picture p61: CAD file, 2019-10-15]
3D print parts/STL/3rd wheel pad unSupport.stl
28.5 x 7.00 x 28.5
