fbezruchko/miro_production/3D print parts/STL/3rdWheel/stator.stl

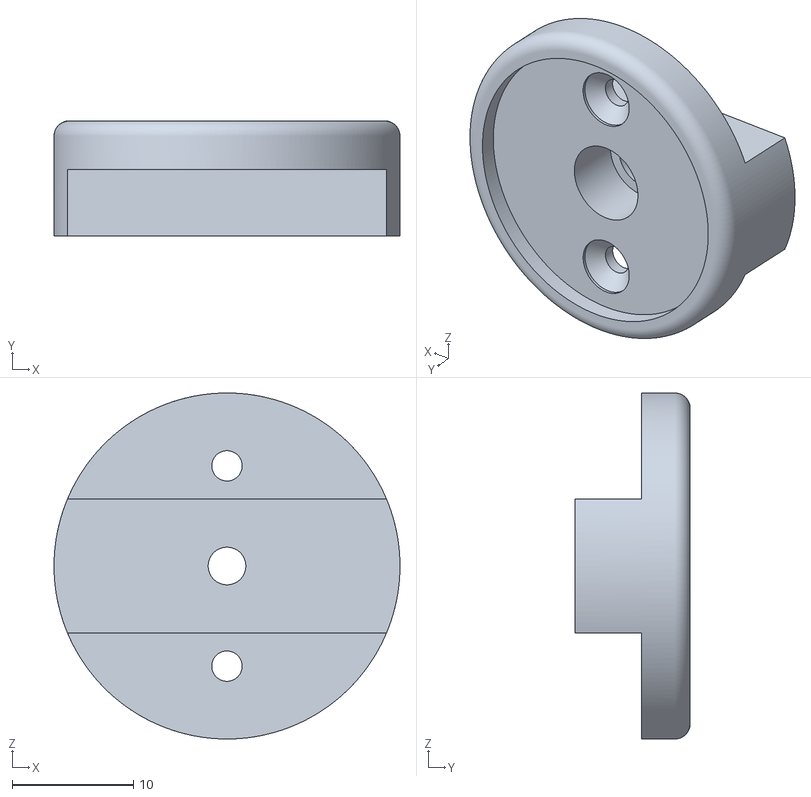
[picture p62: CAD file, 2019-07-06]
3D print parts/STL/3rdWheel/stator.stl
28.5 x 9.50 x 28.5
