fbezruchko/miro_production/3D print parts/STLwSUPPORTS/Back module (Default) wSupport.stl

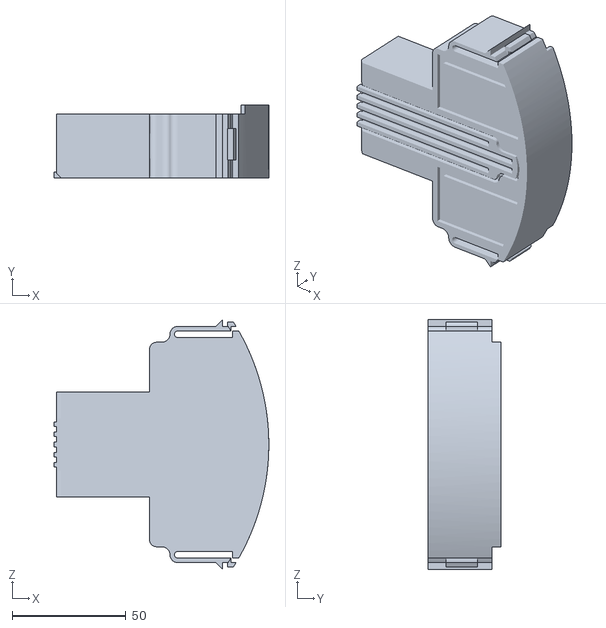
[picture p63: CAD file, 2019-10-15]
3D print parts/STLwSUPPORTS/Back module (Default) wSupport.stl
94.5 x 32.0 x 110.0
