fbezruchko/miro_production/Lasercut parts/Top plate.dxf

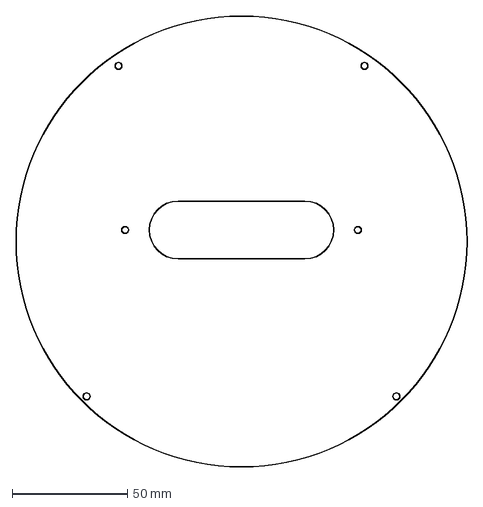
[picture p64: CAD file, 2019-07-06]
Lasercut parts/Top plate.dxf
195.6 x 195.6 mm
