fbezruchko/miro_production/3D print parts/STL/Back bottom cap (right).stl

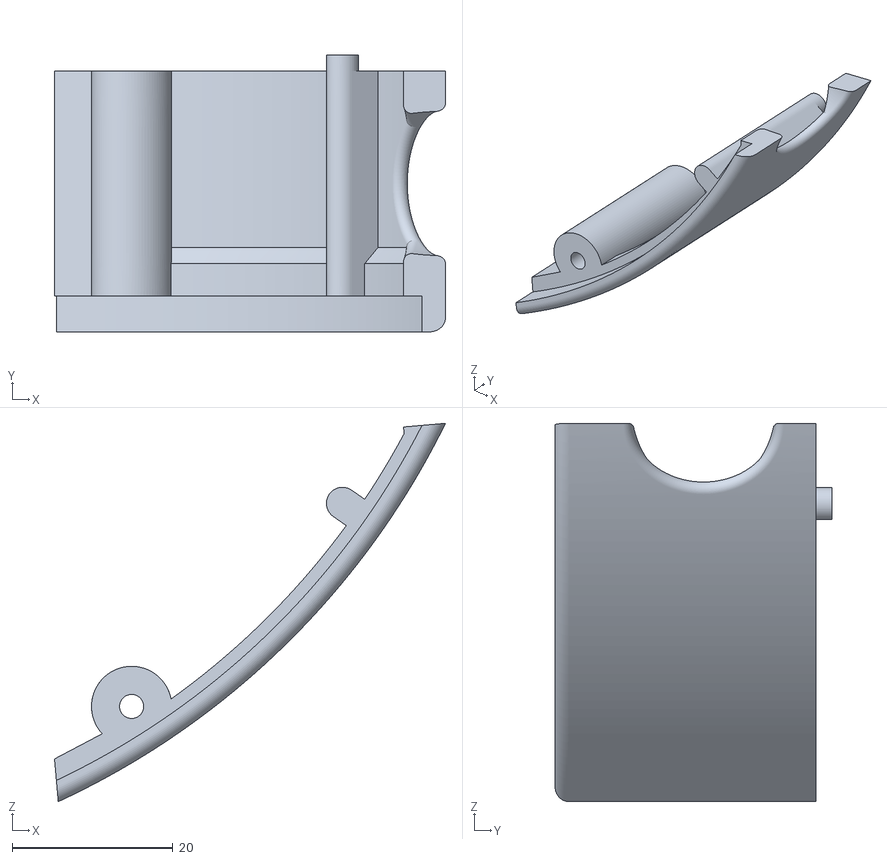
[picture p65: CAD file, 2019-07-06]
3D print parts/STL/Back bottom cap (right).stl
48.7 x 34.5 x 47.2
