fbezruchko/miro_production/3D print parts/STLwSUPPORTS/Front module SENS1 wSupport.stl

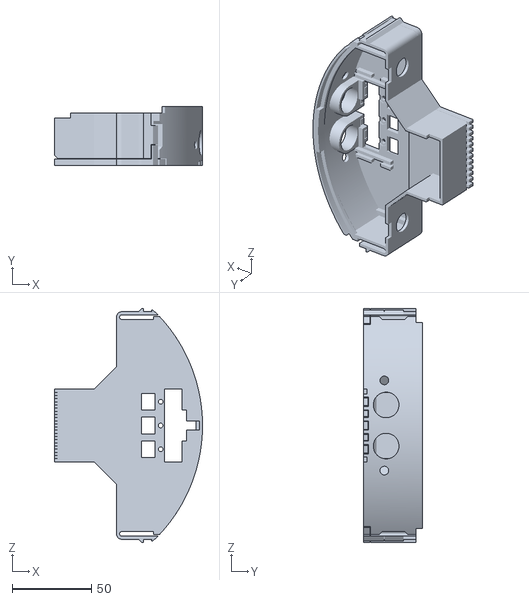
[picture p66: CAD file, 2019-10-15]
3D print parts/STLwSUPPORTS/Front module SENS1 wSupport.stl
93.6 x 37.0 x 148.0
