fbezruchko/miro_production/3D print parts/STL/Handle.stl

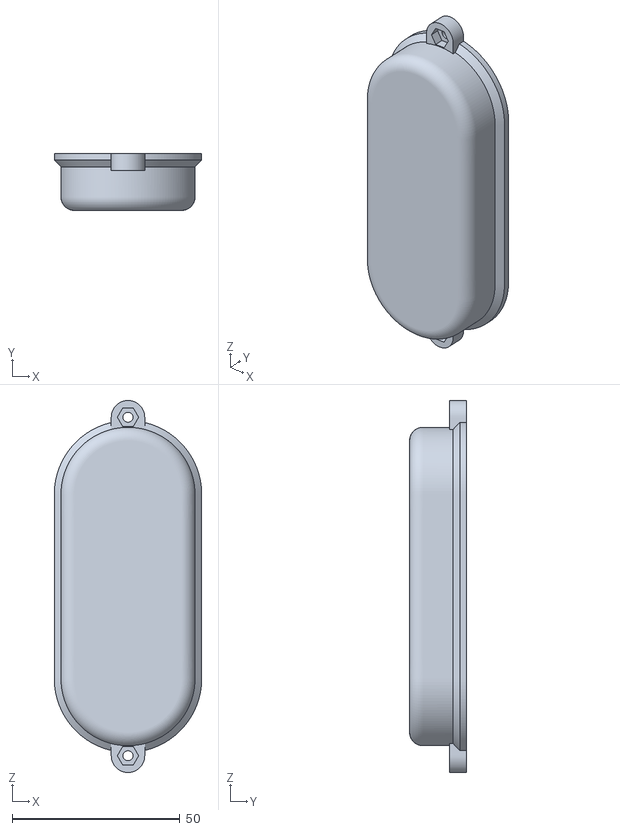
[picture p67: CAD file, 2019-07-06]
3D print parts/STL/Handle.stl
44.0 x 17.0 x 111.0
