fbezruchko/miro_production/3D print parts/STL/Front module SENS1.stl

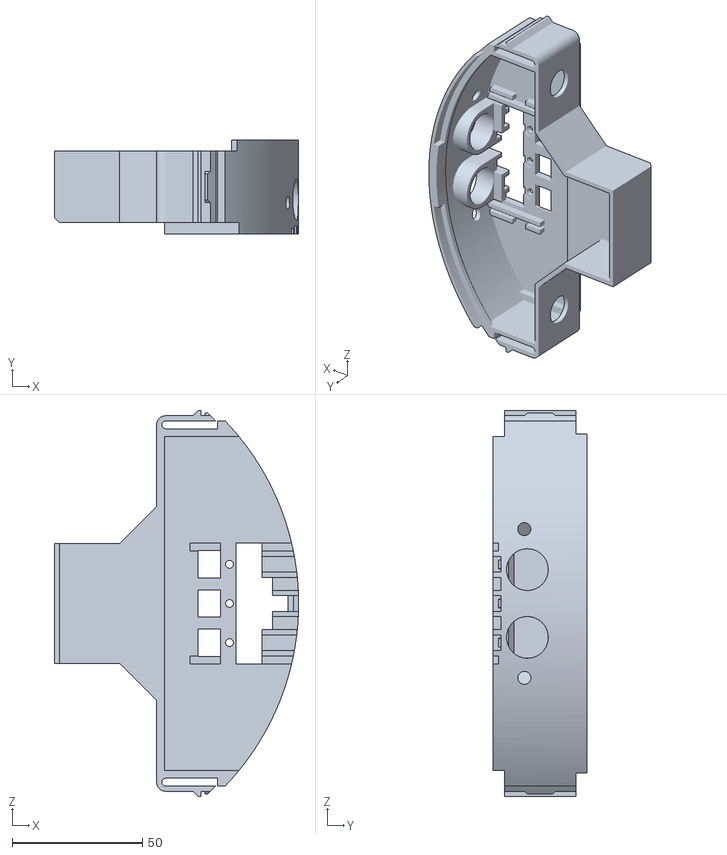
[picture p68: CAD file, 2019-07-06]
3D print parts/STL/Front module SENS1.stl
93.6 x 36.0 x 148.0
