fbezruchko/miro_production/3D print parts/STLwSUPPORTS/Front top cap (right) wSupport.stl

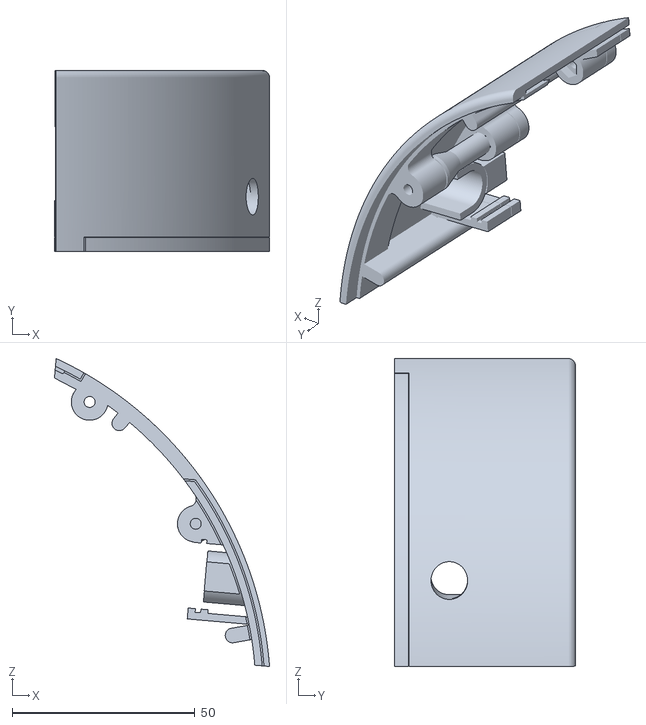
[picture p69: CAD file, 2019-07-06]
3D print parts/STLwSUPPORTS/Front top cap (right) wSupport.stl
58.8 x 49.5 x 84.2
