fbezruchko/miro_production/3D print parts/STL/Back module (Default).stl

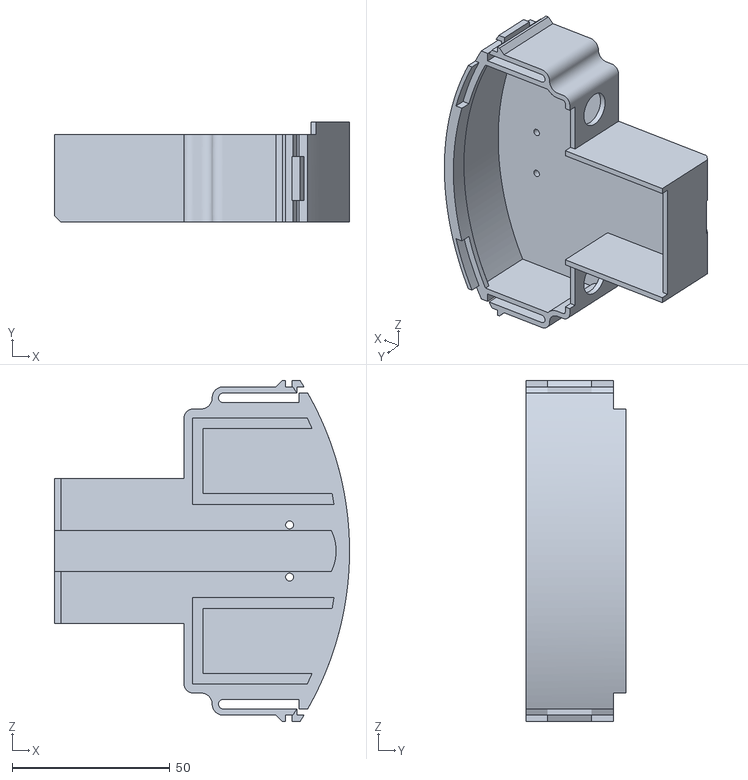
[picture p70: CAD file, 2019-07-06]
3D print parts/STL/Back module (Default).stl
93.5 x 31.7 x 108.0
