fbezruchko/miro_production/3D print parts/STLwSUPPORTS/Servo holder unSupport.stl

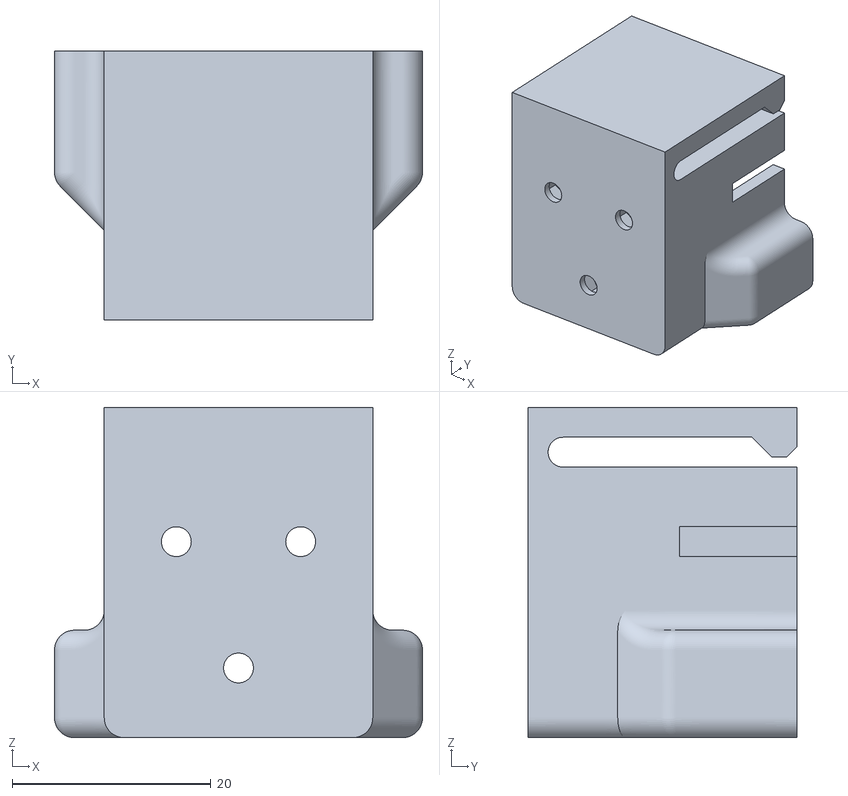
[picture p71: CAD file, 2019-07-06]
3D print parts/STLwSUPPORTS/Servo holder unSupport.stl
37.0 x 27.0 x 33.2
