fbezruchko/miro_production/3D print parts/STL/Back module follower (left) unSupport.stl

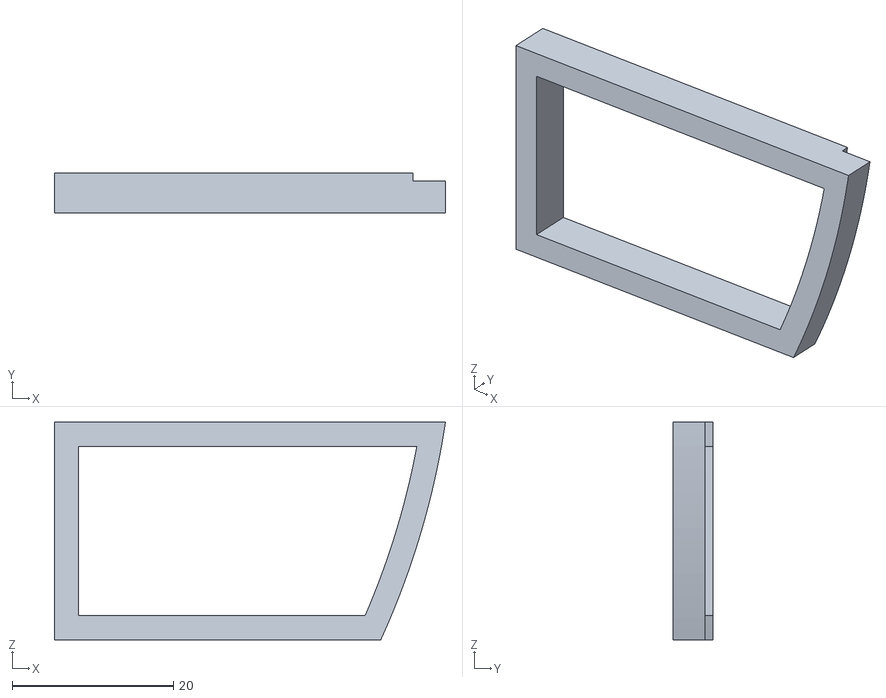
[picture p72: CAD file, 2019-07-06]
3D print parts/STL/Back module follower (left) unSupport.stl
48.5 x 5.00 x 27.0
