fbezruchko/miro_production/3D print parts/STLwSUPPORTS/Back bottom cap (right) wSupport.stl

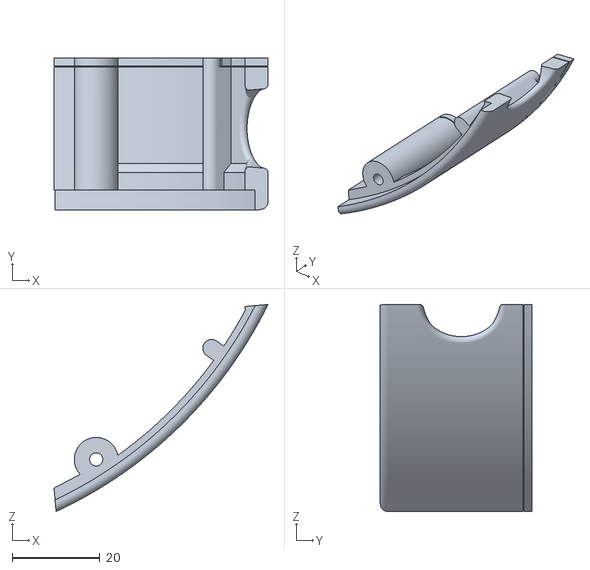
[picture p73: CAD file, 2019-07-06]
3D print parts/STLwSUPPORTS/Back bottom cap (right) wSupport.stl
48.7 x 34.5 x 47.2
