fbezruchko/miro_production/3D print parts/STL/Front bottom cap (right).stl

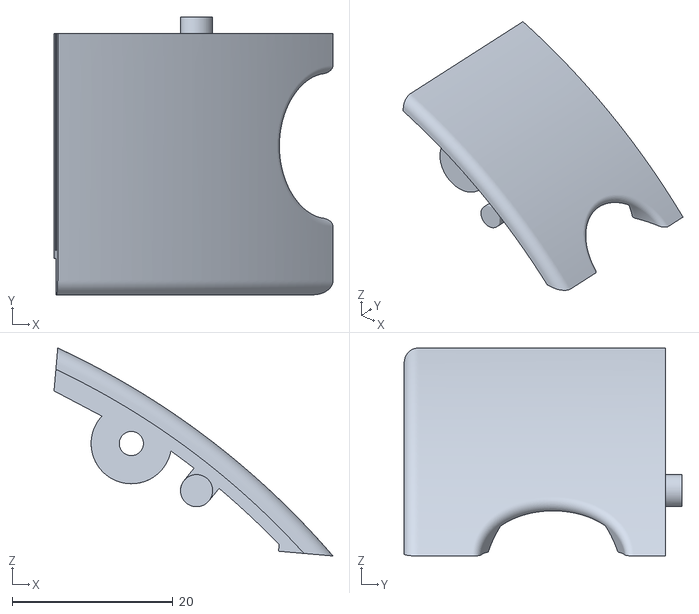
[picture p74: CAD file, 2019-07-06]
3D print parts/STL/Front bottom cap (right).stl
34.7 x 34.5 x 25.8
