fbezruchko/miro_production/3D print parts/STLwSUPPORTS/Front bottom cap (right) wSupport.stl

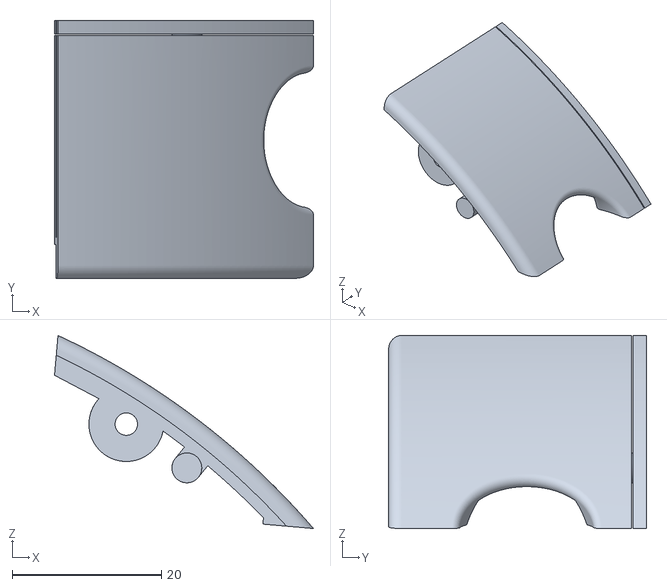
[picture p75: CAD file, 2019-07-06]
3D print parts/STLwSUPPORTS/Front bottom cap (right) wSupport.stl
34.7 x 34.5 x 25.8
