fbezruchko/miro_production/3D print parts/STL/Back top cap (left).stl

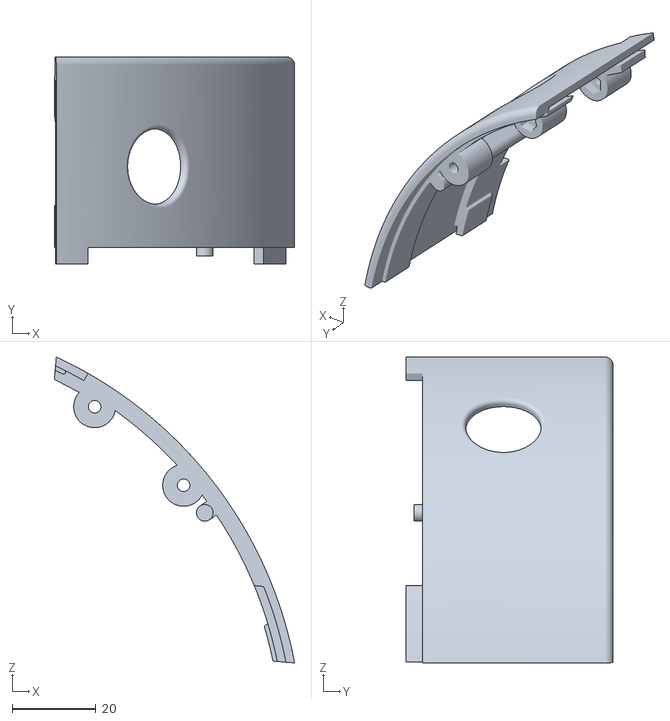
[picture p76: CAD file, 2019-07-06]
3D print parts/STL/Back top cap (left).stl
57.3 x 49.5 x 73.0
