fbezruchko/miro_production/3D print parts/STLwSUPPORTS/Handle wSupport.stl

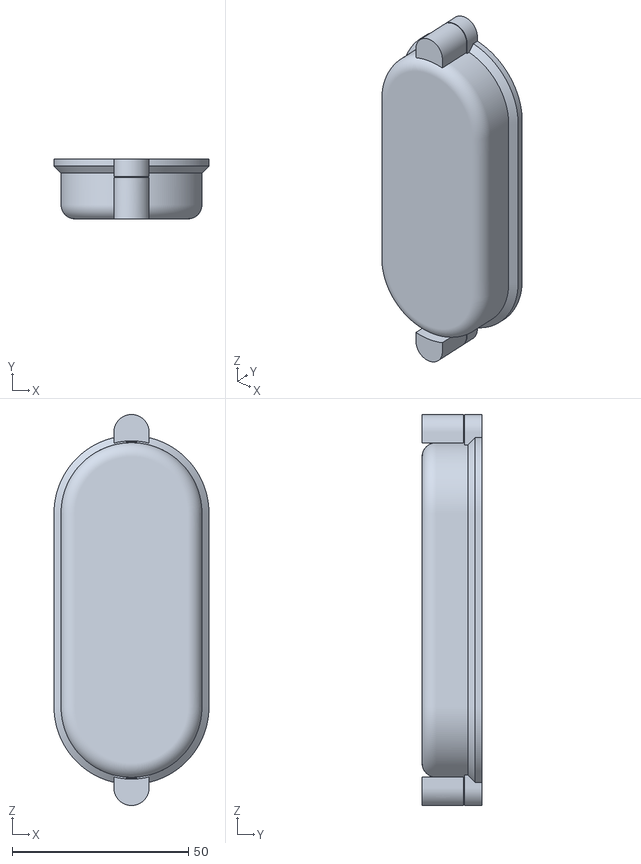
[picture p77: CAD file, 2019-07-06]
3D print parts/STLwSUPPORTS/Handle wSupport.stl
44.0 x 17.0 x 111.0
