fbezruchko/miro_production/3D print parts/STL/Back top cap (right).stl

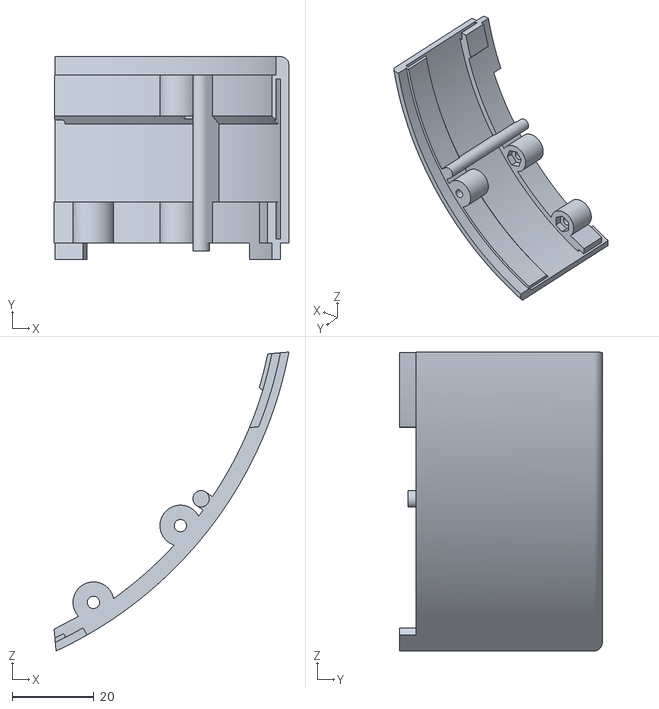
[picture p78: CAD file, 2019-07-06]
3D print parts/STL/Back top cap (right).stl
57.3 x 49.5 x 73.0
