fbezruchko/miro_production/3D print parts/STLwSUPPORTS/Odometry wheel (x2) unSupport.stl

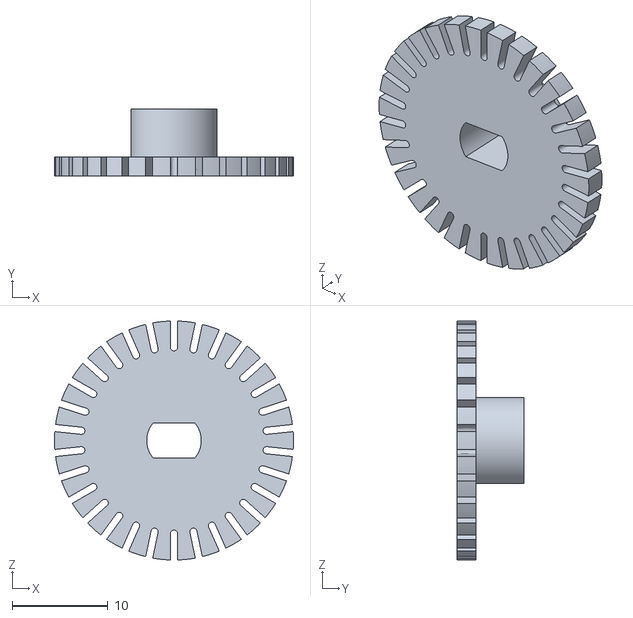
[picture p79: CAD file, 2019-07-06]
3D print parts/STLwSUPPORTS/Odometry wheel (x2) unSupport.stl
25.0 x 7.00 x 25.0
