fbezruchko/miro_production/3D print parts/STL/Front top cap (right).stl

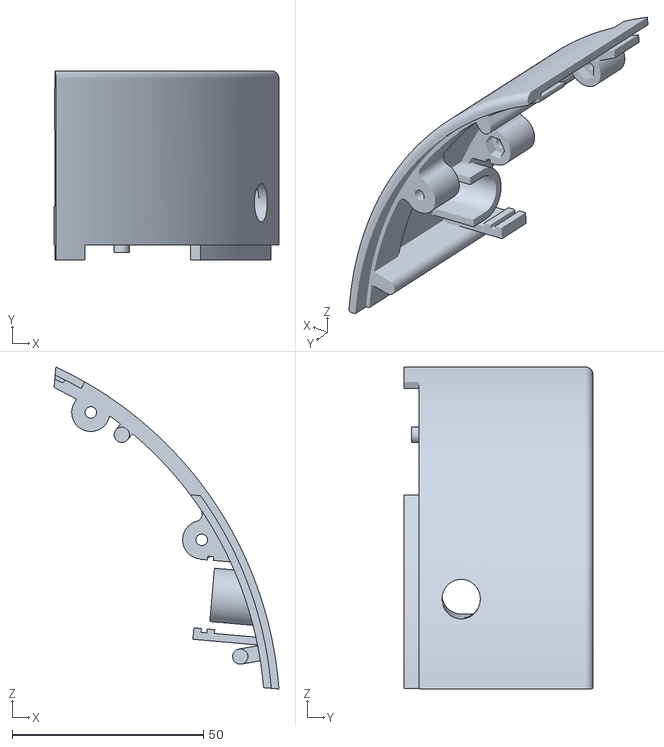
[picture p80: CAD file, 2019-07-06]
3D print parts/STL/Front top cap (right).stl
58.8 x 49.5 x 84.2
