fbezruchko/miro_production/3D print parts/STLwSUPPORTS/Back top cap (left) wSupport.stl

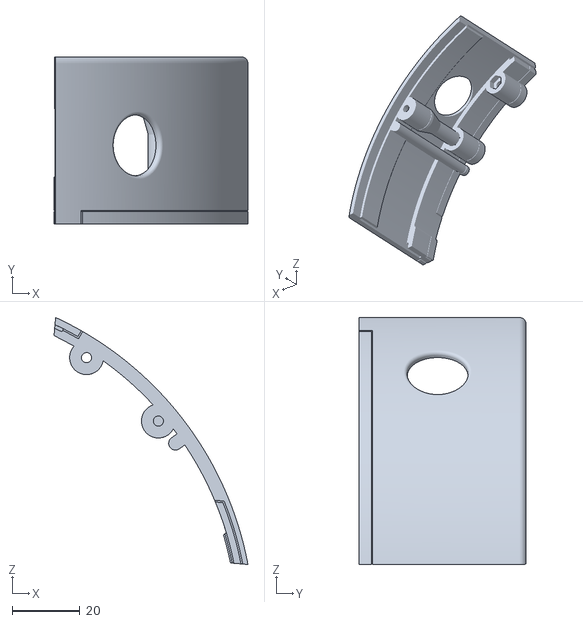
[picture p81: CAD file, 2019-07-06]
3D print parts/STLwSUPPORTS/Back top cap (left) wSupport.stl
57.3 x 49.5 x 73.0
