fbezruchko/miro_production/3D print parts/STLwSUPPORTS/RPi pad unSupport.stl

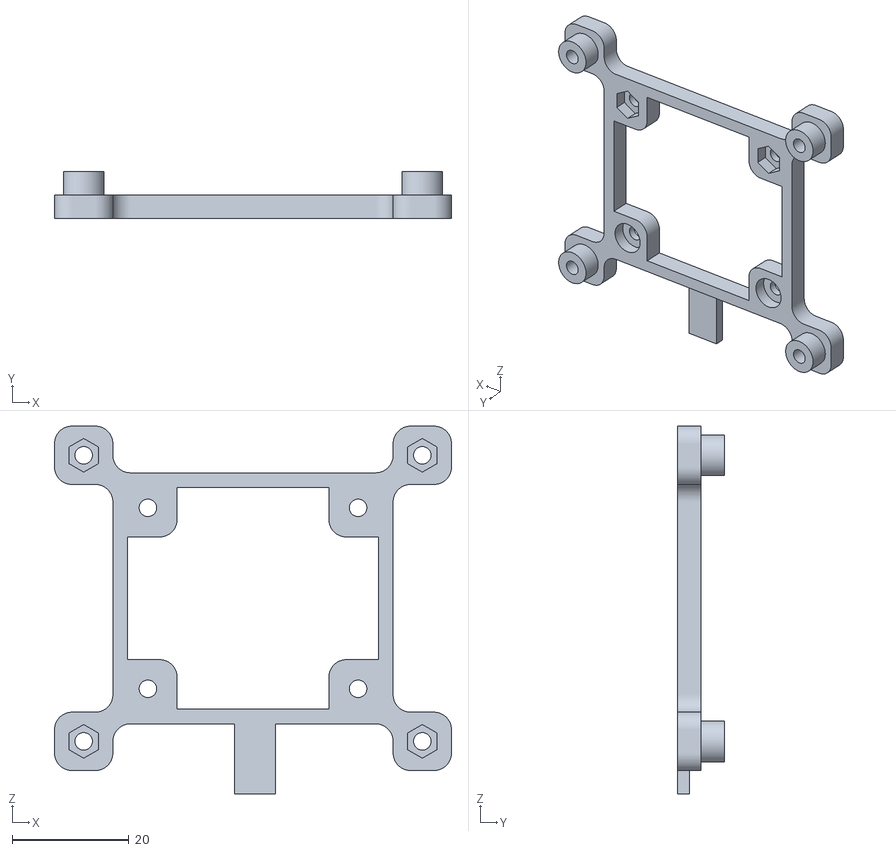
[picture p82: CAD file, 2019-07-06]
3D print parts/STLwSUPPORTS/RPi pad unSupport.stl
68.0 x 8.00 x 63.0
