fbezruchko/miro_production/3D print parts/STL/ARDUINO pad unSupport.stl

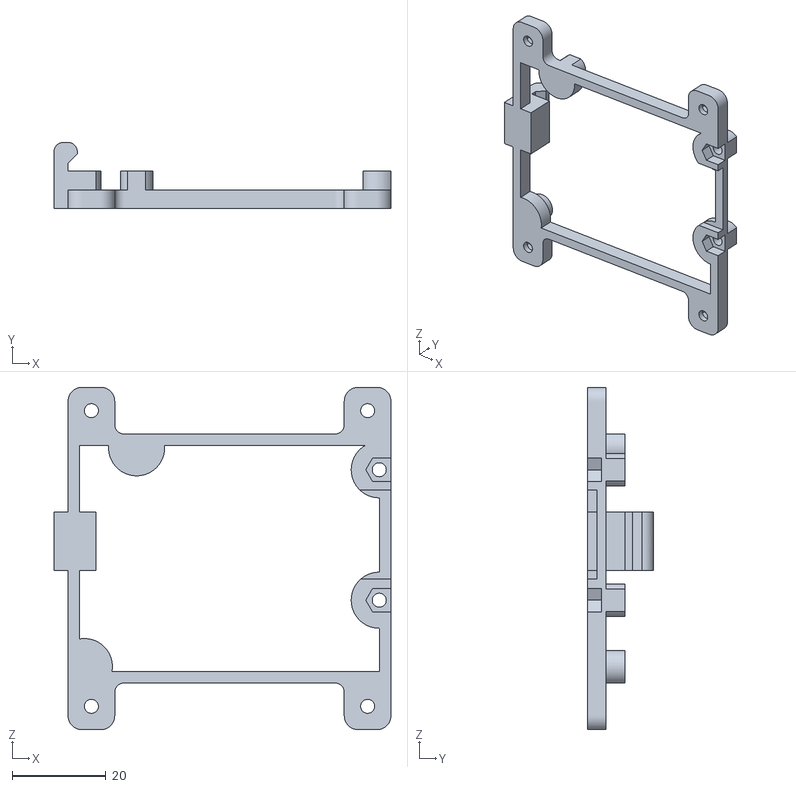
[picture p83: CAD file, 2019-07-06]
3D print parts/STL/ARDUINO pad unSupport.stl
72.1 x 14.2 x 73.2
