fbezruchko/miro_production/3D print parts/STLwSUPPORTS/Front module SENS1 follower unSupport.stl

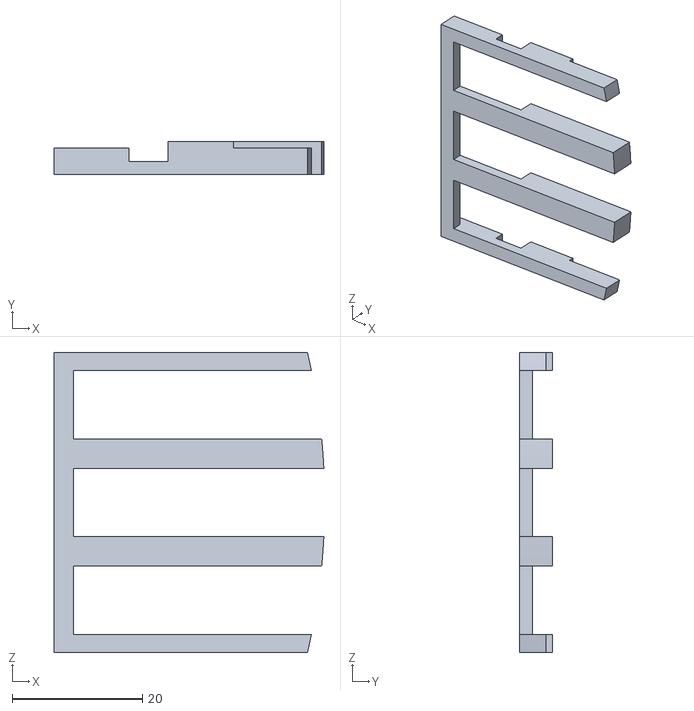
[picture p84: CAD file, 2019-07-06]
3D print parts/STLwSUPPORTS/Front module SENS1 follower unSupport.stl
41.4 x 5.00 x 46.0
