fbezruchko/miro_production/3D print parts/STL/Camera holder.stl

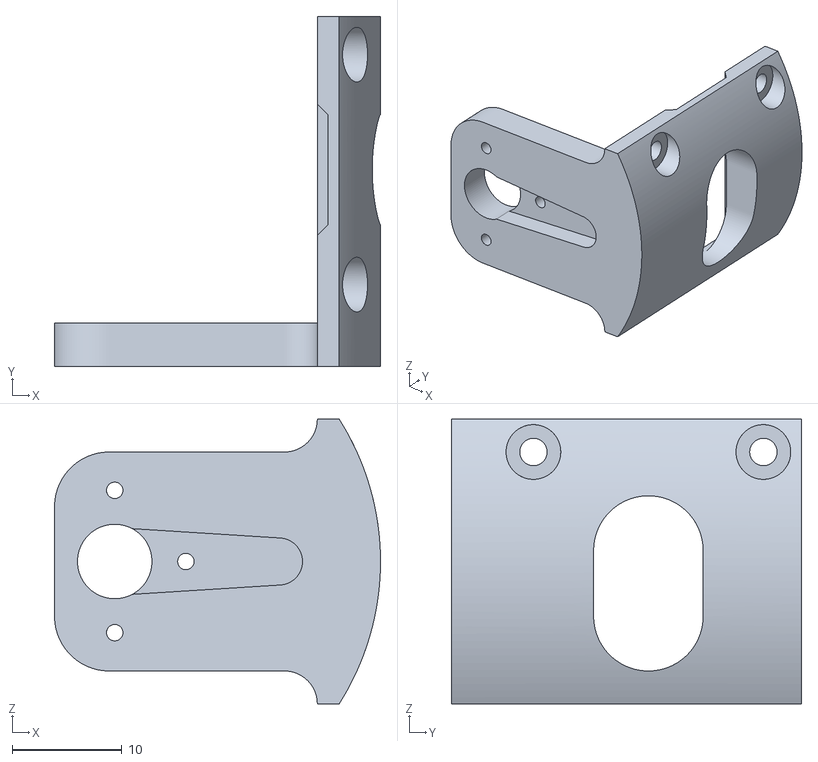
[picture p85: CAD file, 2019-07-06]
3D print parts/STL/Camera holder.stl
29.8 x 32.0 x 26.0
