fbezruchko/miro_production/3D print parts/STLwSUPPORTS/Wheel unSupport.stl

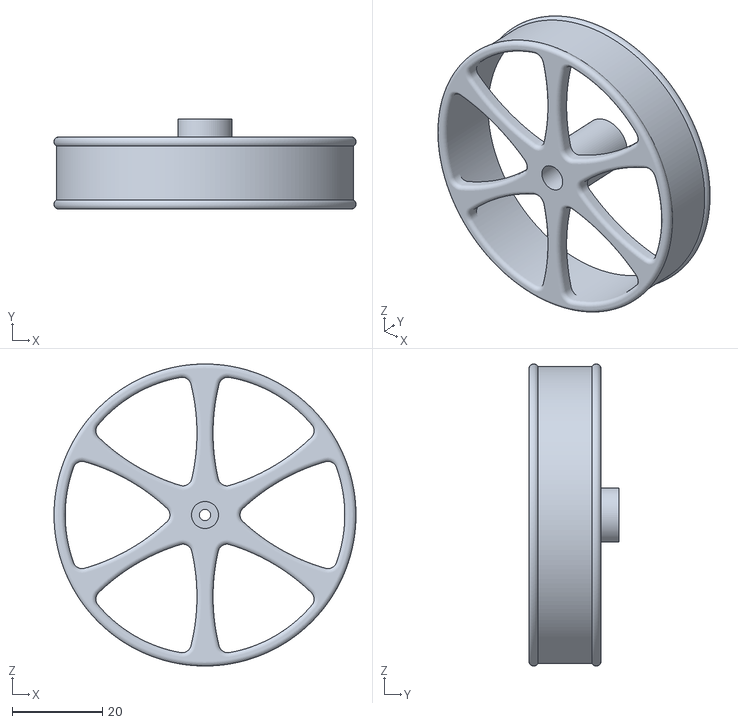
[picture p86: CAD file, 2019-07-06]
3D print parts/STLwSUPPORTS/Wheel unSupport.stl
67.0 x 20.0 x 67.0
