fbezruchko/miro_production/3D print parts/STLwSUPPORTS/Camera holder wSupport.stl

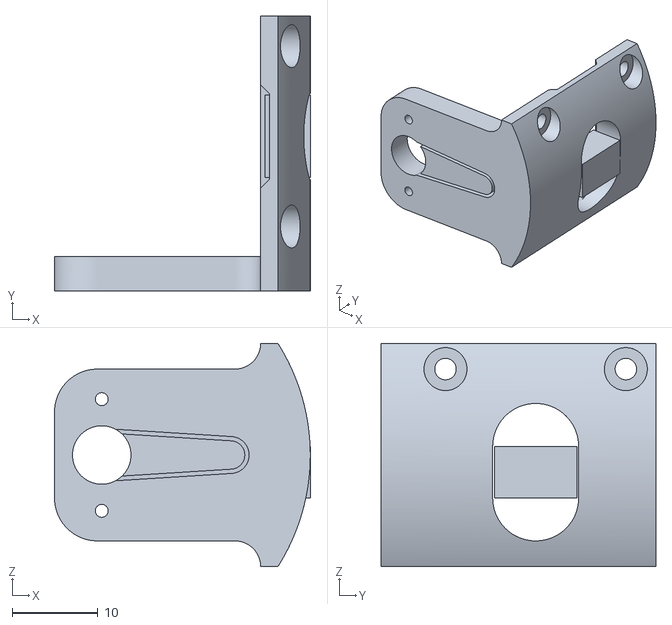
[picture p87: CAD file, 2019-07-06]
3D print parts/STLwSUPPORTS/Camera holder wSupport.stl
29.8 x 32.0 x 26.0
