fbezruchko/miro_production/3D print parts/STLwSUPPORTS/Motor holder (right) unSupport.stl

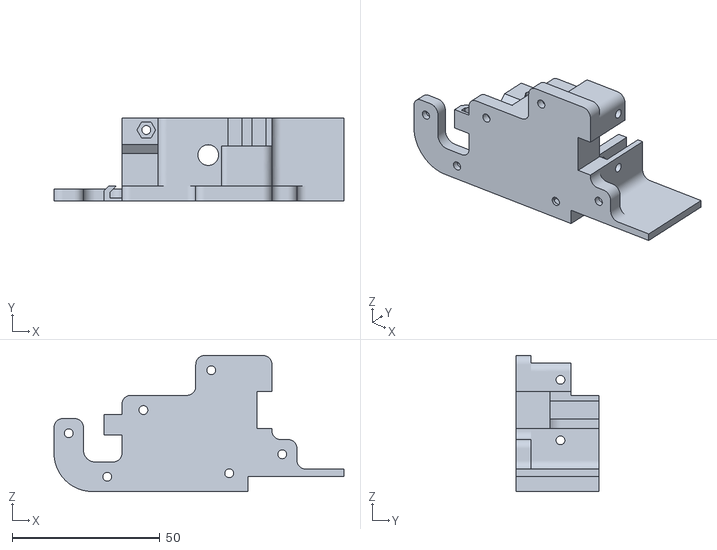
[picture p88: CAD file, 2019-07-06]
3D print parts/STLwSUPPORTS/Motor holder (right) unSupport.stl
98.3 x 28.0 x 46.1
