fbezruchko/miro_production/(list of files, cad)

Other CAD files:
3D print parts/STLwSUPPORTS/Back top cap (right) wSupport.stl
