fbezruchko/miro_production/(threads)

Thread 1 (2019-10-15):

Front top cap very deep nut

fbezruchko, 2019-10-15:
Надо сделать углубление под гайку в стенке деталей Front top capчуть меньше, чтобы ее можно было вставить и запрессовать. А также развернуть ее, чтобы вставлялась в сторону стенки ребром (шлицем), а не гранью.
