fbezruchko/miro_production/CONNECTION DIAGRAM.pdf

## UART

# BUZZER GPIO¹⁴

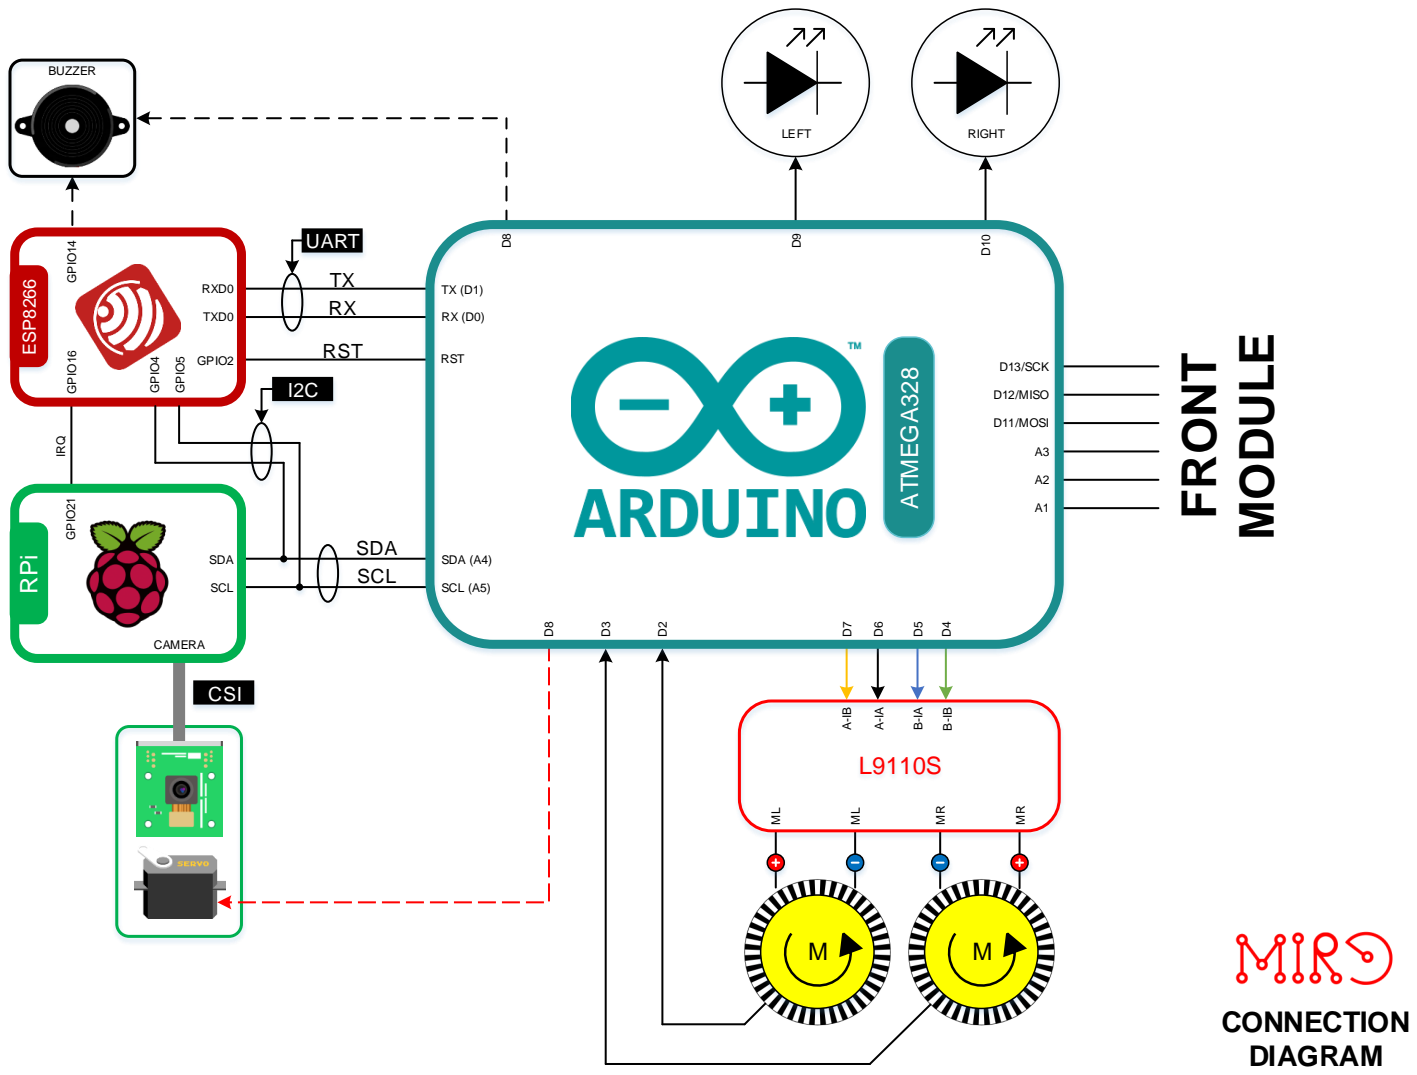
[picture p89: page 1]

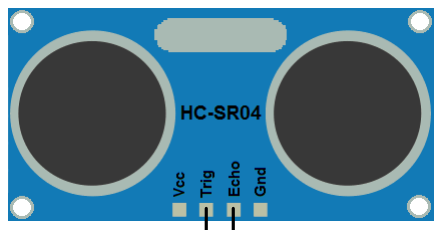
[picture p90: figure]

A1
A2

A3

LEFT | MIDDLE | RIGHT
LEFT | RIGHT ATMEGA³²⁸

## D11/MOSI D13/SCK

D12/MISO

A2
A3

# FRONT MODULE CONNECTION

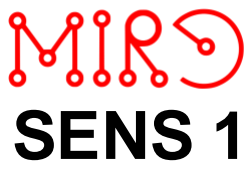
[picture p91: figure]

DIAGRAM | SENS 1

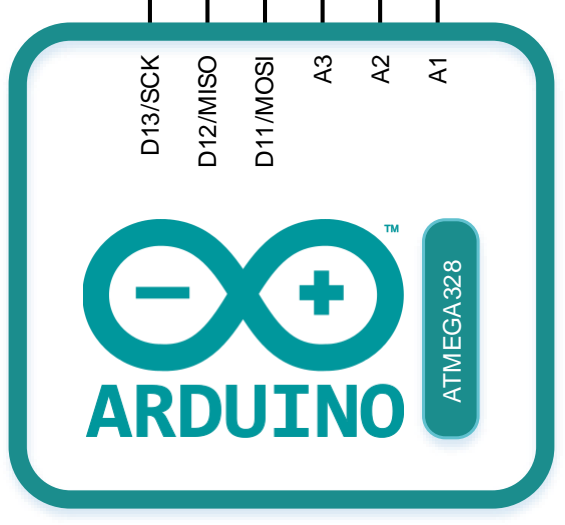
[picture p92: figure]
D13/SCK; D12/MISO

## Li-ION Battery

2S (7.4V)

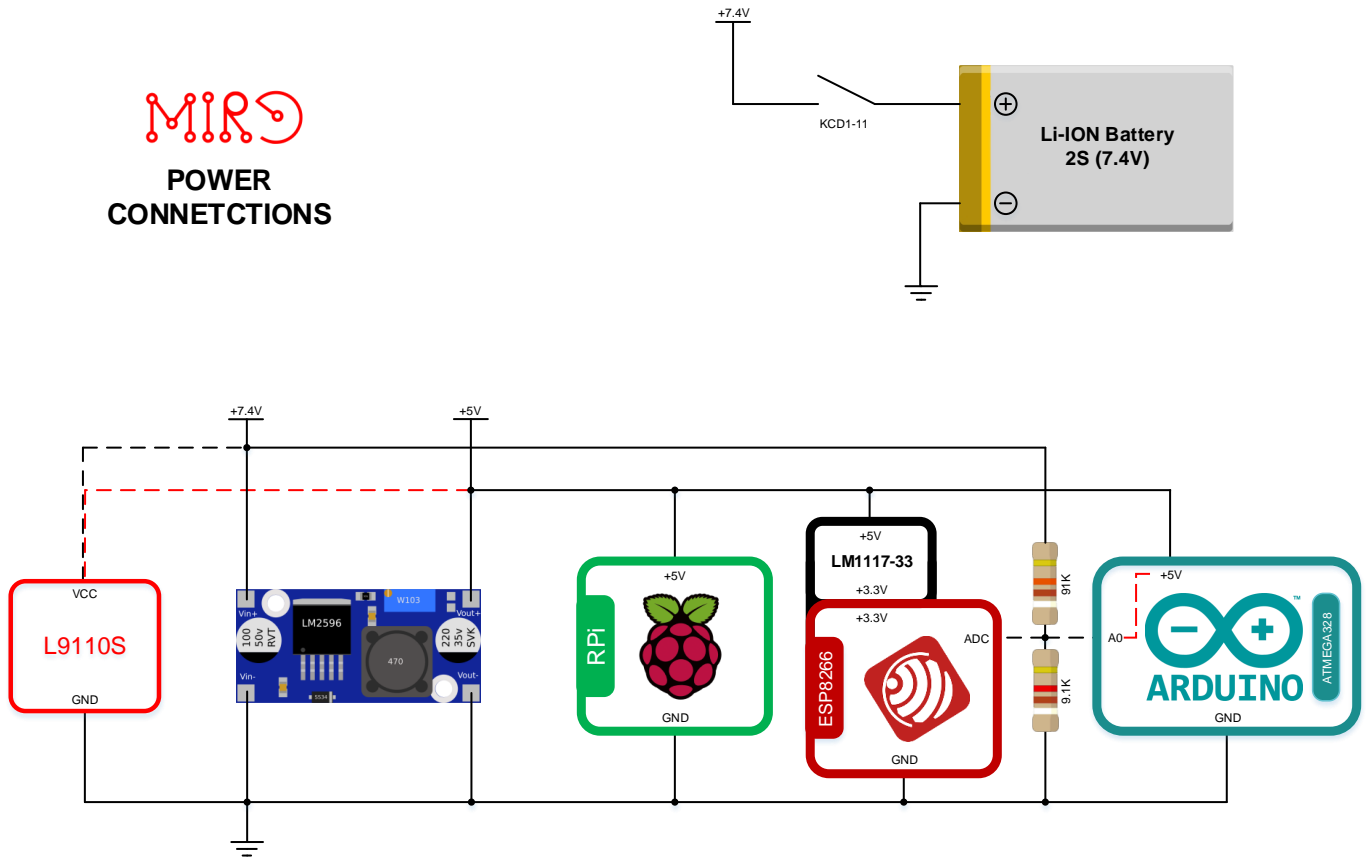
[picture p93: page 3]
ESP8266; RPi; ATMEGA328; GND; VCC; ADC; KCD1-11; POWER CONNETCTIONS
