fbezruchko/miro_production/(commit log)

2019-07-06 first upload
    [ARDUINO pad unSupport.stl, Back bottom cap (right) wSupport.stl, Back bottom cap (right).stl, Back module (Default) wSupport.stl, Back module (Default).stl, Back module follower (right) unSupport.stl, Back top cap (left) wSupport.stl, Back top cap (left).stl]
2019-10-15 new parts models, add connection diagram
    [3rd wheel pad unSupport.stl, Back module (Default) wSupport.stl, Back module follower (left) unSupport.stl, Base plate.dxf, Bottom plate.dxf, Front module SENS1 wSupport.stl, Odometry wheel v2019 (x2) unSupport.stl, PVC cap (back).dxf]
